danpillay87/puppet-base-cad/out/superseded/README.txt

DO NOT PRINT ANYTHING IN THIS FOLDER.

These are the old two-piece base plate halves (base_plate_left, base_plate_right) and
their assembly copies. On 23 Oct 2026 they were replaced by the one-piece
out/base_plate.stl, which is the one to print. They are kept here for reference only.
