danpillay87/puppet-base-cad/out/preview_rest.png

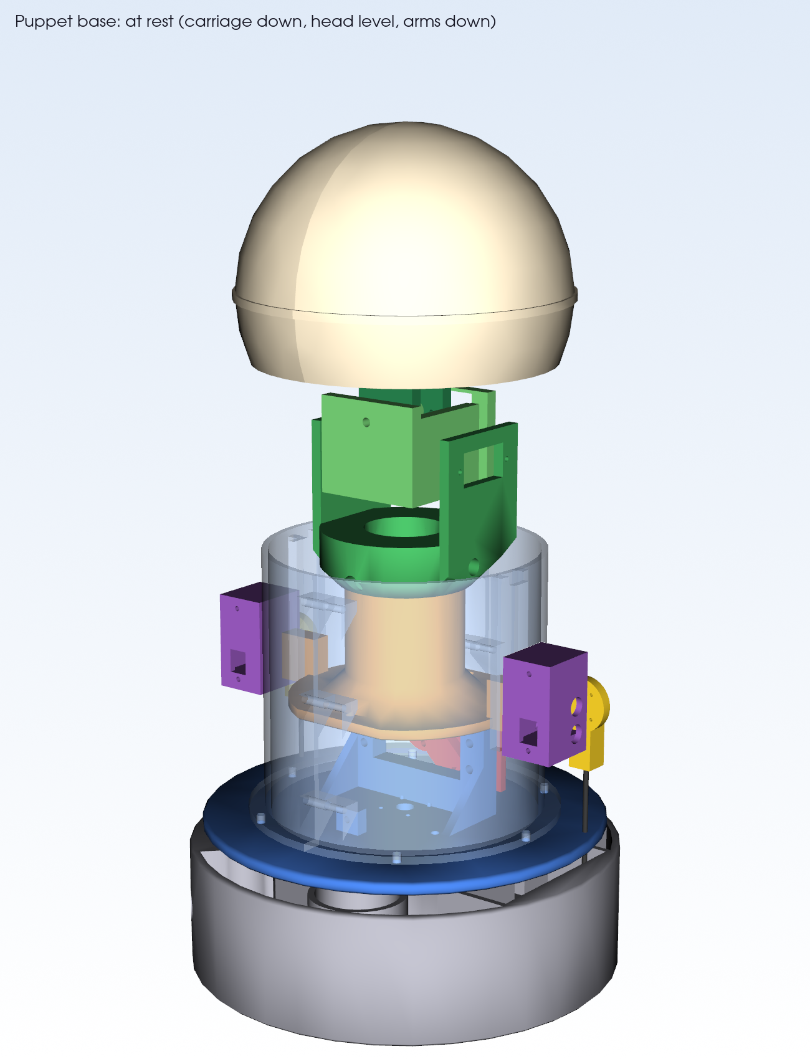
out/preview_rest.png
