danpillay87/puppet-base-cad/sim/assets/cad/cad-check.png

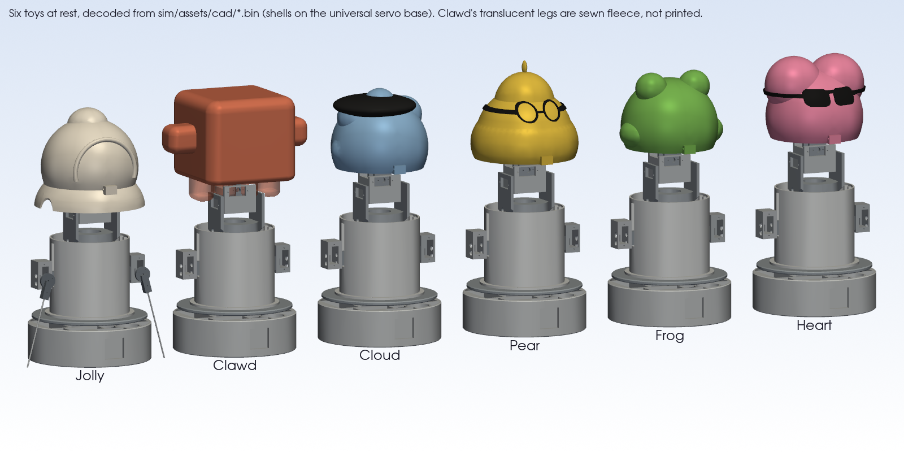
sim/assets/cad/cad-check.png
