danpillay87/puppet-base-cad/out/_assembly/_pose/bobbed/base.stl

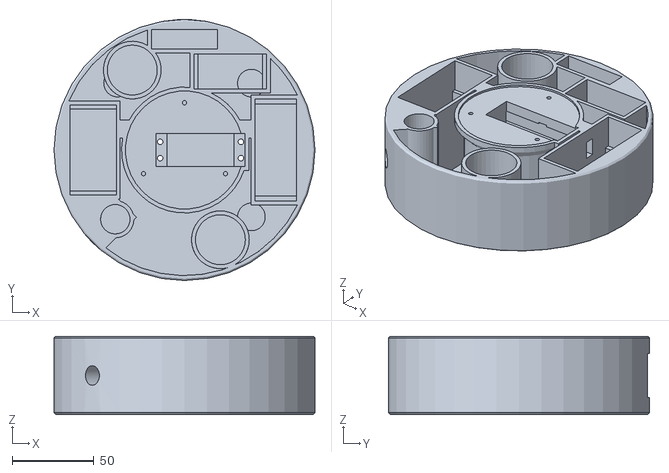
[picture p10: CAD file, 2026-10-24]
out/_assembly/_pose/bobbed/base.stl
160.0 x 160.0 x 48.0
