danpillay87/puppet-base-cad/out/_assembly/_pose/claude_bobbed/neck_B.stl

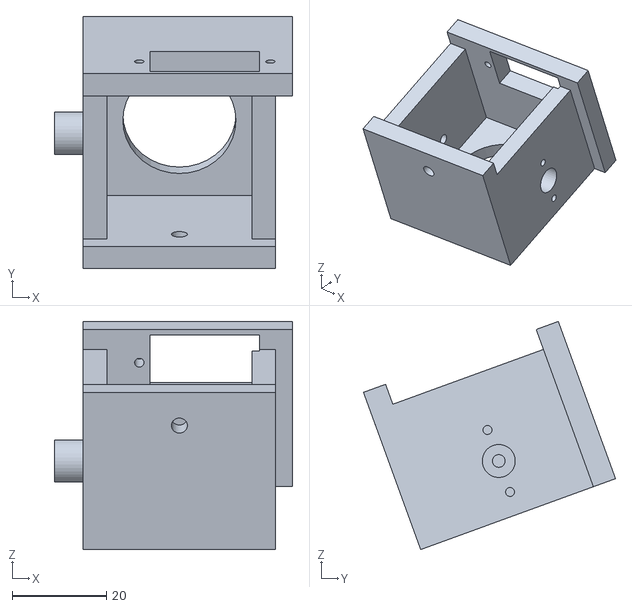
[picture p11: CAD file, 2026-10-23]
out/_assembly/_pose/claude_bobbed/neck_B.stl
50.5 x 53.5 x 48.4
