danpillay87/puppet-base-cad/out/_assembly/_pose/claude_rest/neck_A.stl

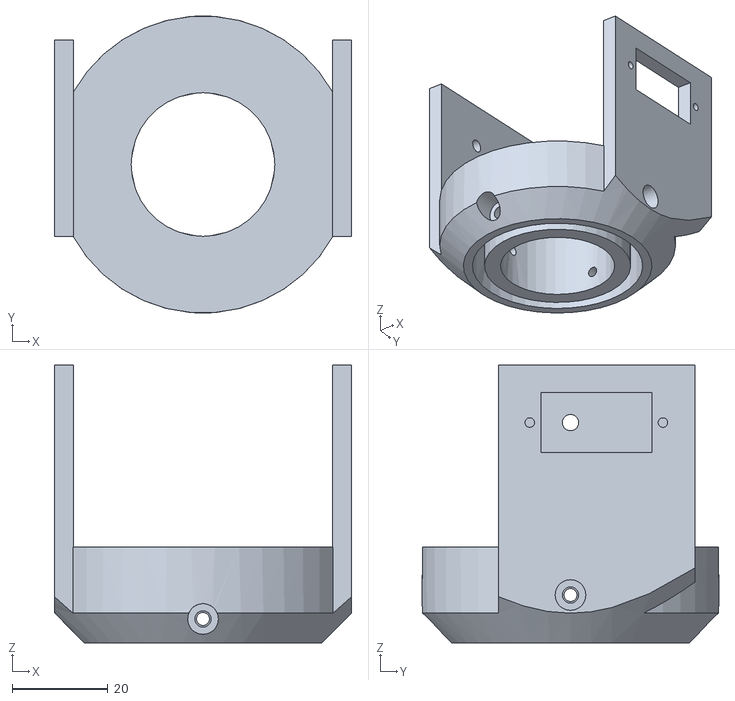
[picture p12: CAD file, 2026-10-23]
out/_assembly/_pose/claude_rest/neck_A.stl
62.0 x 62.0 x 58.0
