danpillay87/puppet-base-cad/out/_assembly/_shells/_pose/wearer_glasses.stl

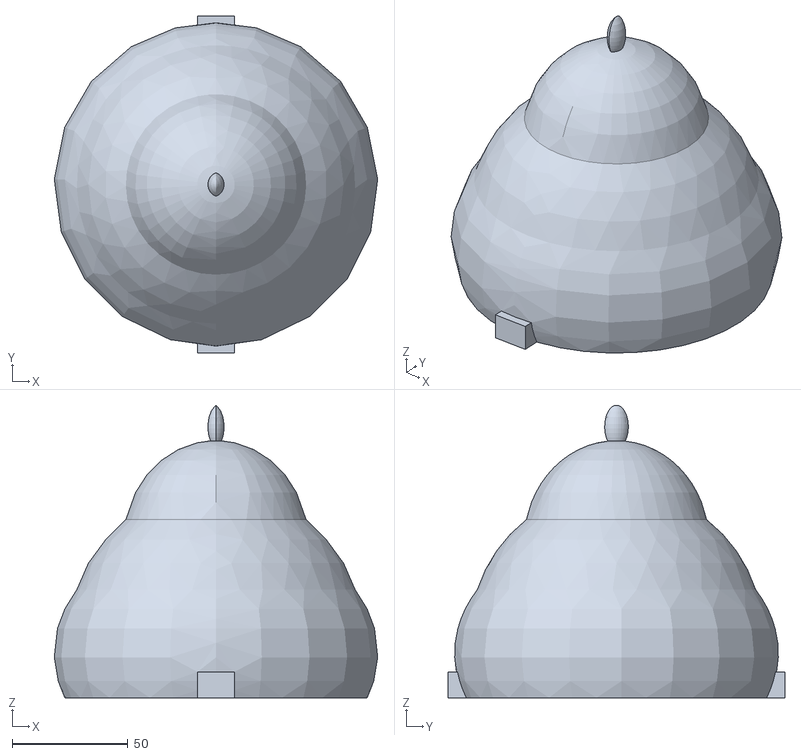
[picture p13: CAD file, 2026-10-23]
out/_assembly/_shells/_pose/wearer_glasses.stl
139.9 x 145.7 x 126.5
