danpillay87/puppet-base-cad/out/_assembly/_shells/glasses.stl

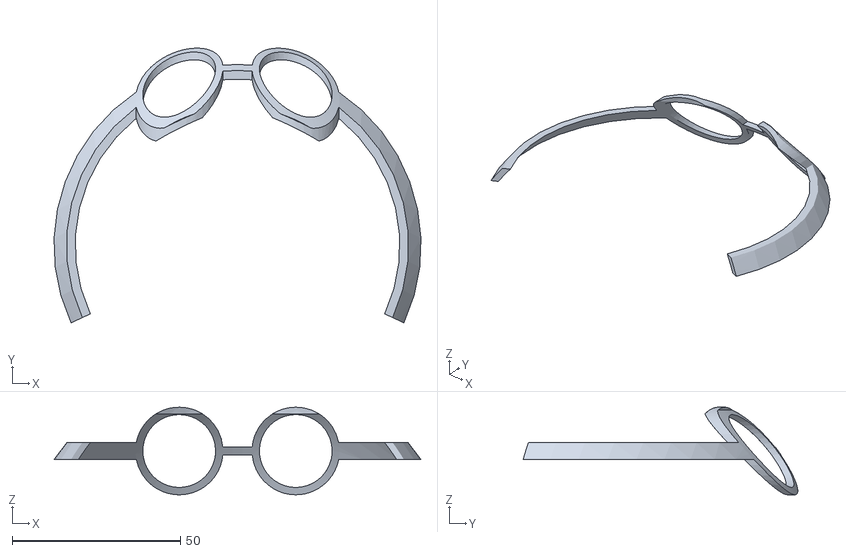
[picture p14: CAD file, 2026-10-23]
out/_assembly/_shells/glasses.stl
108.9 x 81.5 x 26.0
