danpillay87/puppet-base-cad/out/_assembly/_pose/claude_bobbed/turntable_hub.stl

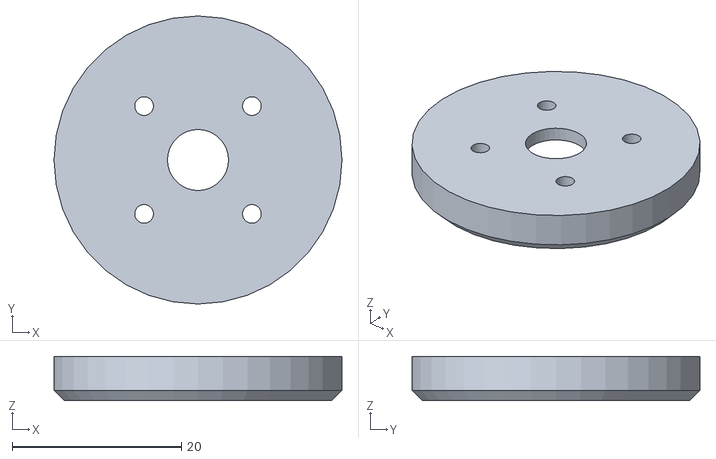
[picture p15: CAD file, 2026-10-23]
out/_assembly/_pose/claude_bobbed/turntable_hub.stl
34.0 x 34.0 x 5.20
