danpillay87/puppet-base-cad/out/_assembly/_pose/claude_rest/base.stl

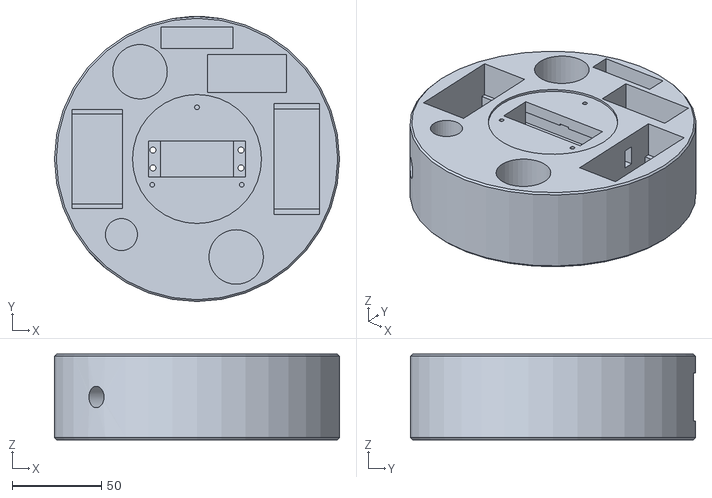
[picture p16: CAD file, 2026-10-23]
out/_assembly/_pose/claude_rest/base.stl
160.0 x 160.0 x 48.0
