danpillay87/puppet-base-cad/out/_assembly/_pose/cloud/turntable.stl

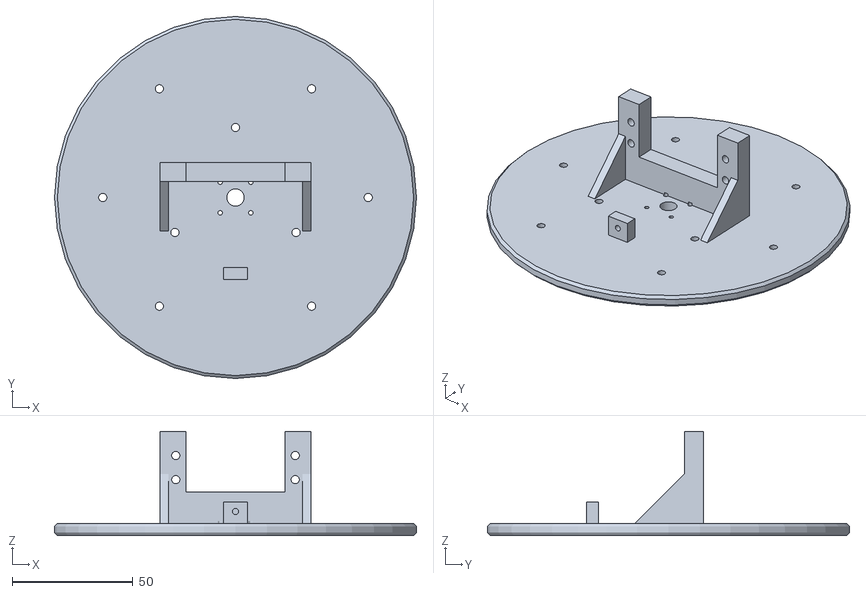
[picture p17: CAD file, 2026-10-23]
out/_assembly/_pose/cloud/turntable.stl
150.0 x 150.0 x 43.2
