danpillay87/puppet-base-cad/out/_assembly/_pose/rest/socket_L.stl

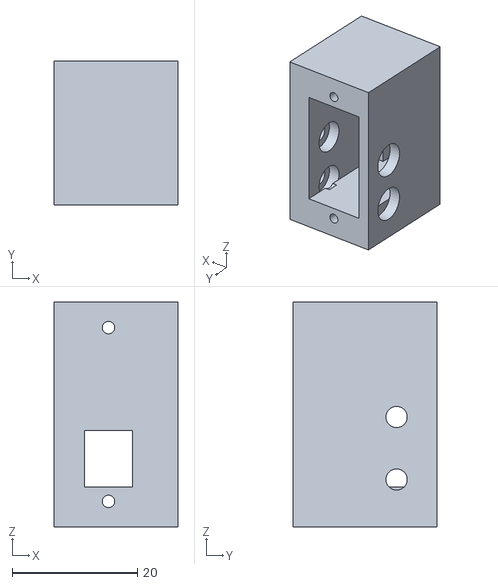
[picture p18: CAD file, 2026-10-23]
out/_assembly/_pose/rest/socket_L.stl
19.8 x 23.1 x 36.0
