danpillay87/puppet-base-cad/out/_assembly/_shells/sunglasses.stl

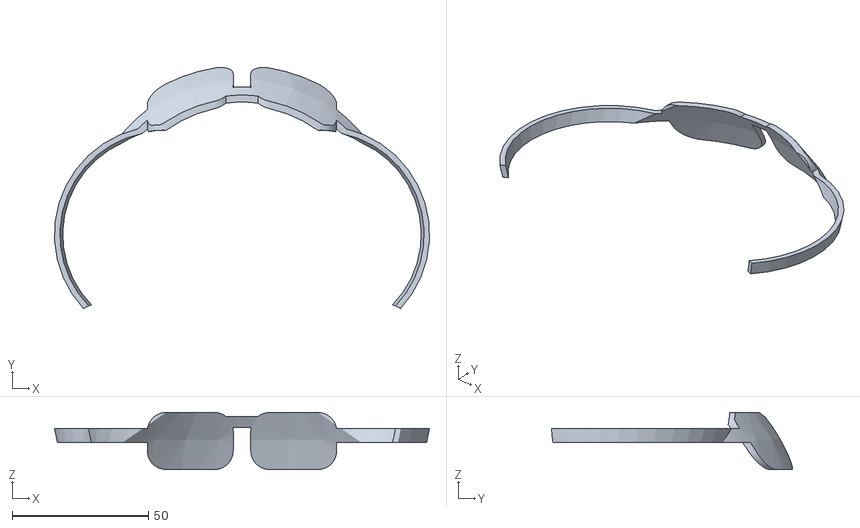
[picture p19: CAD file, 2026-10-23]
out/_assembly/_shells/sunglasses.stl
137.7 x 88.5 x 21.0
