danpillay87/puppet-base-cad/out/neck_rocker_B.stl

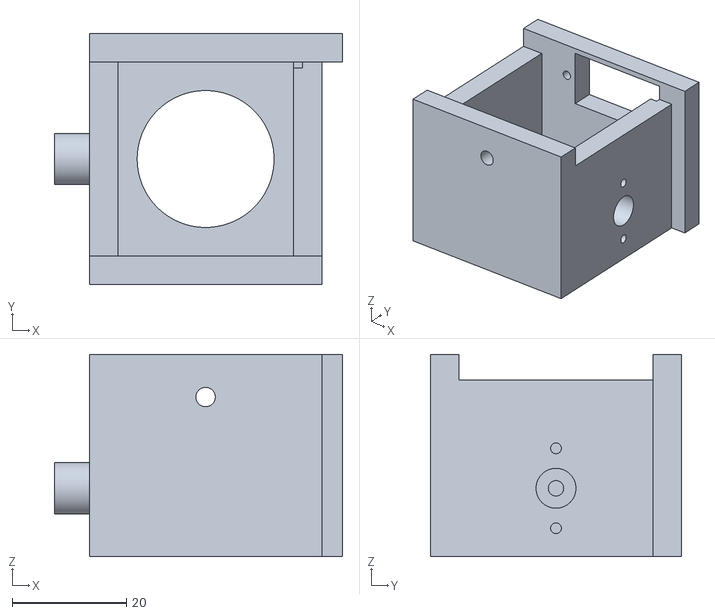
[picture p20: CAD file, 2026-10-23]
out/neck_rocker_B.stl
50.5 x 44.0 x 35.5
