danpillay87/puppet-base-cad/out/_assembly/_shells/claude_legs.stl

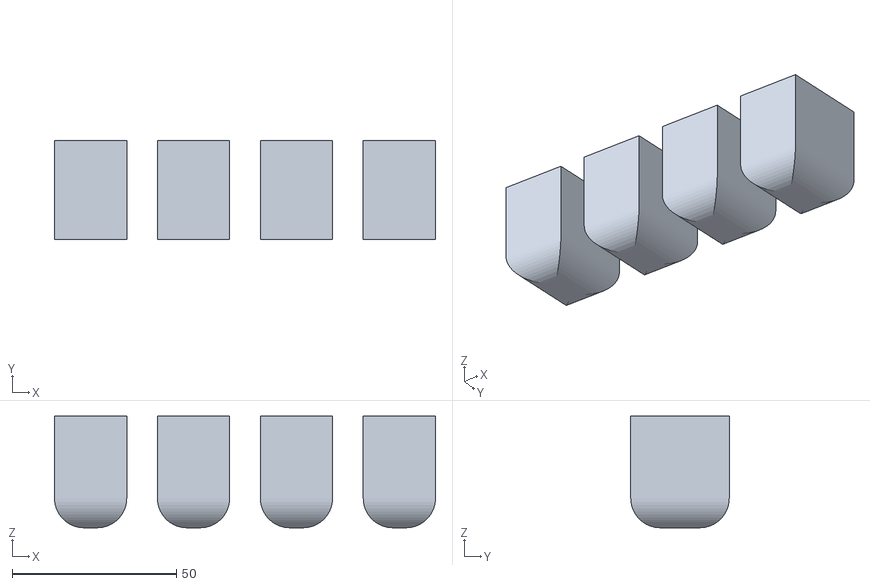
[picture p21: CAD file, 2026-10-20]
out/_assembly/_shells/claude_legs.stl
116.0 x 30.0 x 34.0
