danpillay87/puppet-base-cad/out/_assembly/_shells/_pose/wearer_sunglasses.stl

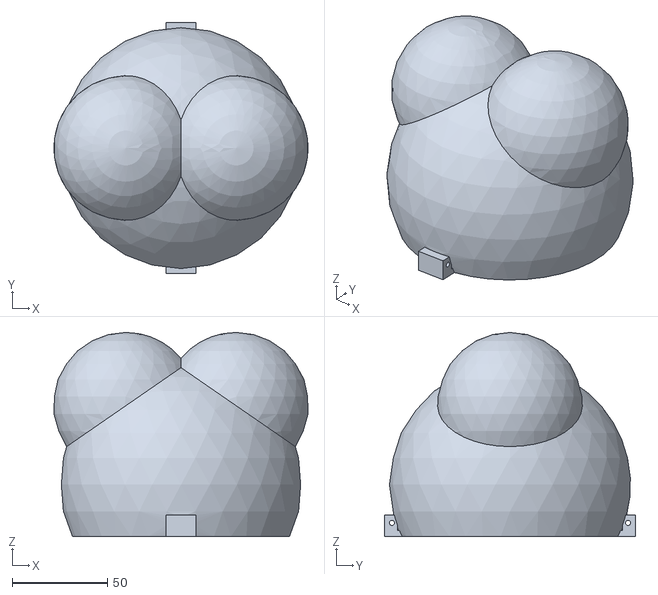
[picture p22: CAD file, 2026-10-23]
out/_assembly/_shells/_pose/wearer_sunglasses.stl
133.4 x 132.0 x 107.2
