danpillay87/puppet-base-cad/out/_assembly/_shells/claude.stl

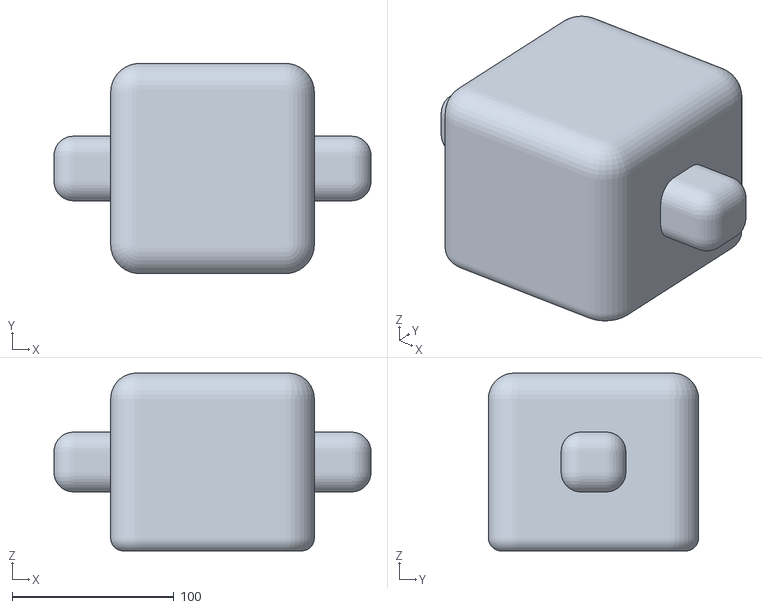
[picture p23: CAD file, 2026-10-20]
out/_assembly/_shells/claude.stl
196.0 x 130.0 x 110.0
