danpillay87/puppet-base-cad/out/_assembly/_shells/_pose/frog.stl

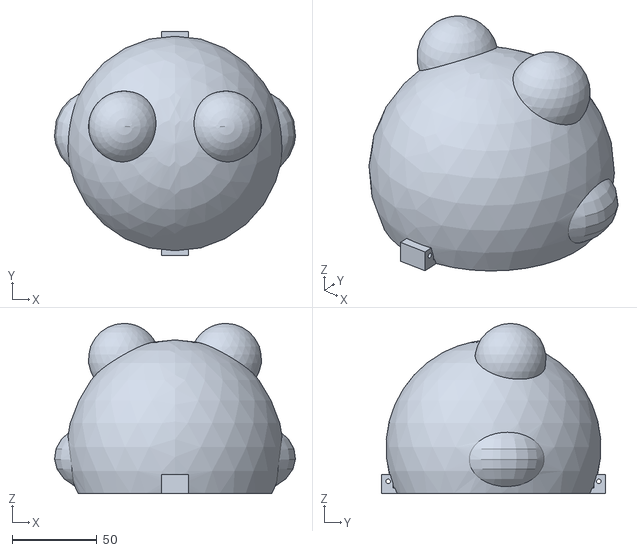
[picture p24: CAD file, 2026-10-20]
out/_assembly/_shells/_pose/frog.stl
141.8 x 132.0 x 100.2
