danpillay87/puppet-base-cad/out/_assembly/_shells/_pose/cloud.stl

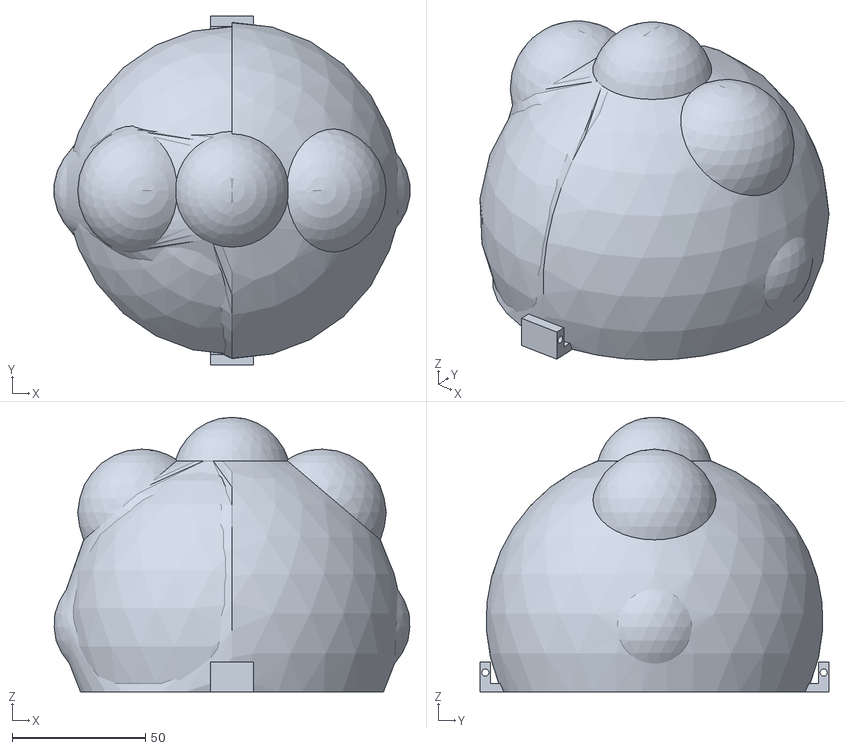
[picture p25: CAD file, 2026-10-20]
out/_assembly/_shells/_pose/cloud.stl
133.7 x 131.2 x 103.2
