danpillay87/puppet-base-cad/out/_assembly/_shells/beret.stl

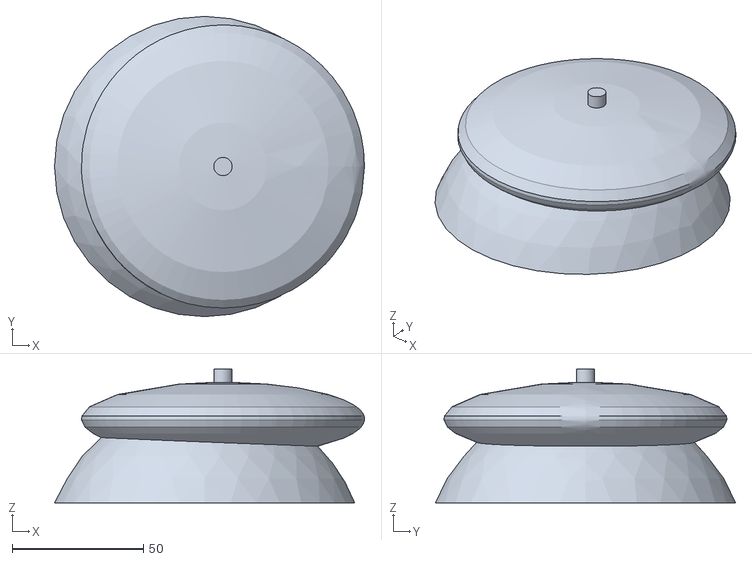
[picture p26: CAD file, 2026-10-18]
out/_assembly/_shells/beret.stl
118.3 x 114.5 x 51.0
