danpillay87/puppet-base-cad/out/_assembly/_shells/_pose/jolly.stl

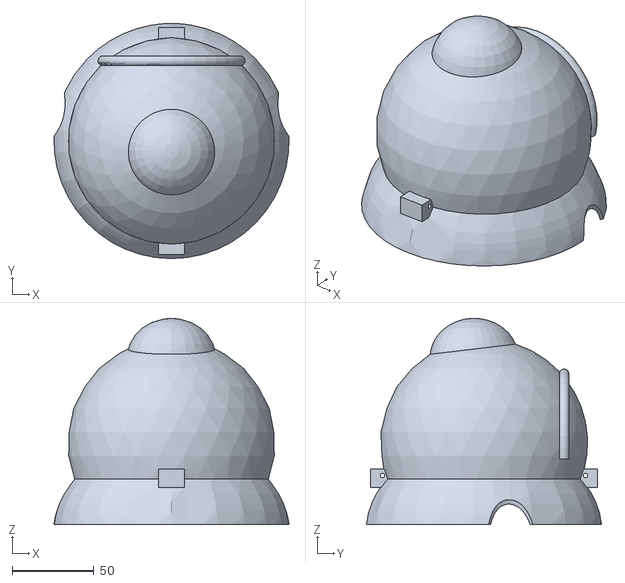
[picture p27: CAD file, 2026-10-20]
out/_assembly/_shells/_pose/jolly.stl
143.5 x 143.6 x 126.0
