danpillay87/puppet-base-cad/out/_assembly/_pose/bobbed/base_L.stl

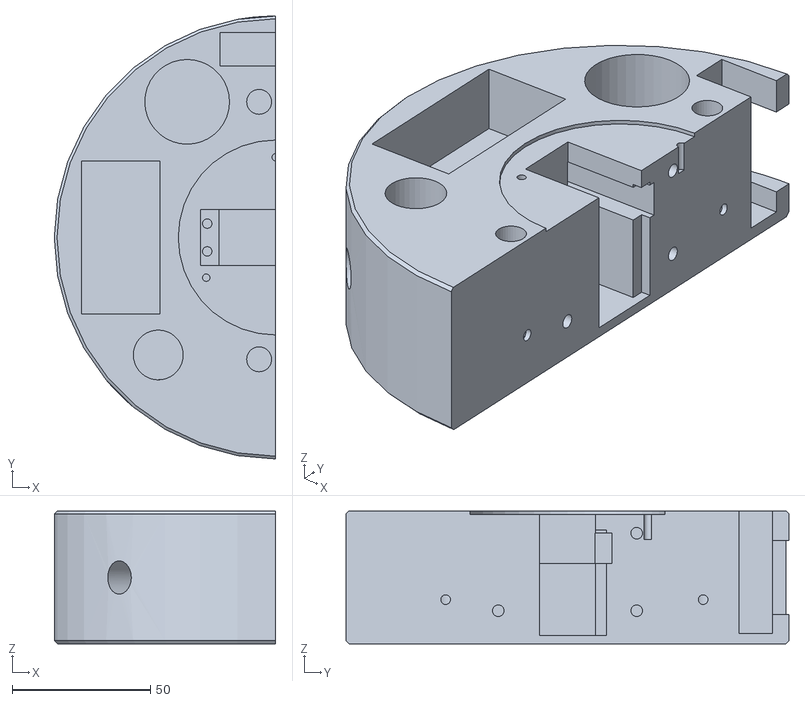
[picture p28: CAD file, 2026-10-18]
out/_assembly/_pose/bobbed/base_L.stl
80.0 x 160.0 x 48.0
