danpillay87/puppet-base-cad/out/_assembly/_pose/claude_bobbed/claude_legs.stl

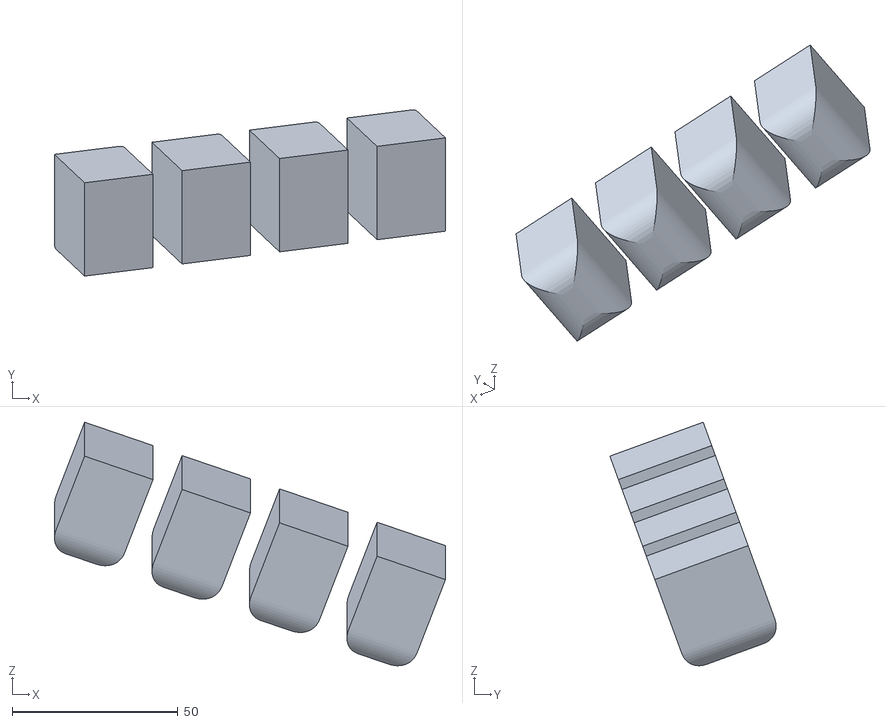
[picture p29: CAD file, 2026-10-20]
out/_assembly/_pose/claude_bobbed/claude_legs.stl
118.1 x 50.2 x 73.6
