danpillay87/puppet-base-cad/out/_assembly/_pose/claude_rest/lever.stl

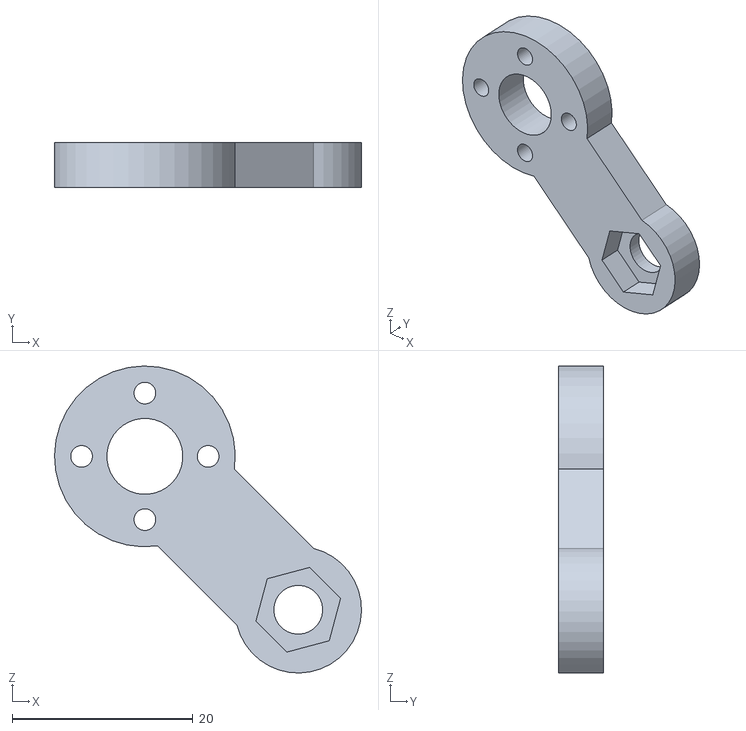
[picture p30: CAD file, 2026-10-20]
out/_assembly/_pose/claude_rest/lever.stl
34.0 x 5.00 x 34.0
