danpillay87/puppet-base-cad/out/_assembly/_pose/bobbed/base_R.stl

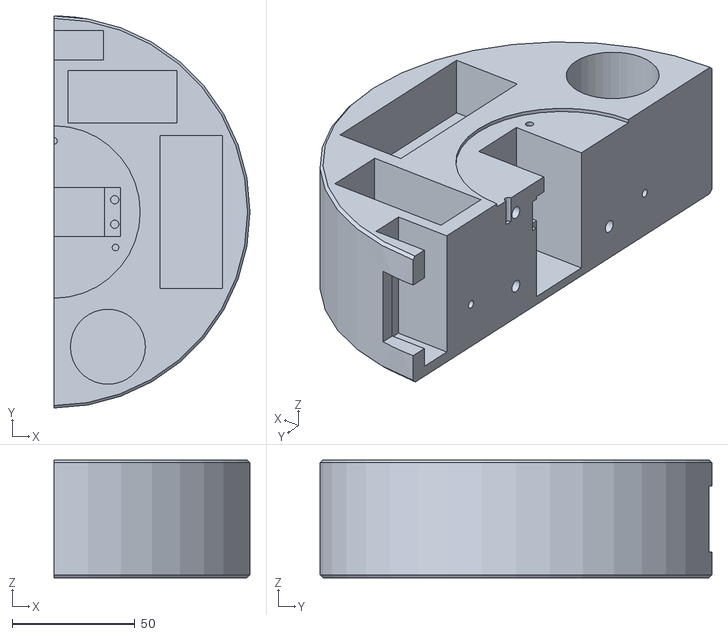
[picture p32: CAD file, 2026-10-18]
out/_assembly/_pose/bobbed/base_R.stl
80.0 x 160.0 x 48.0
