danpillay87/puppet-base-cad/out/_assembly/_pose/cloud/carriage.stl

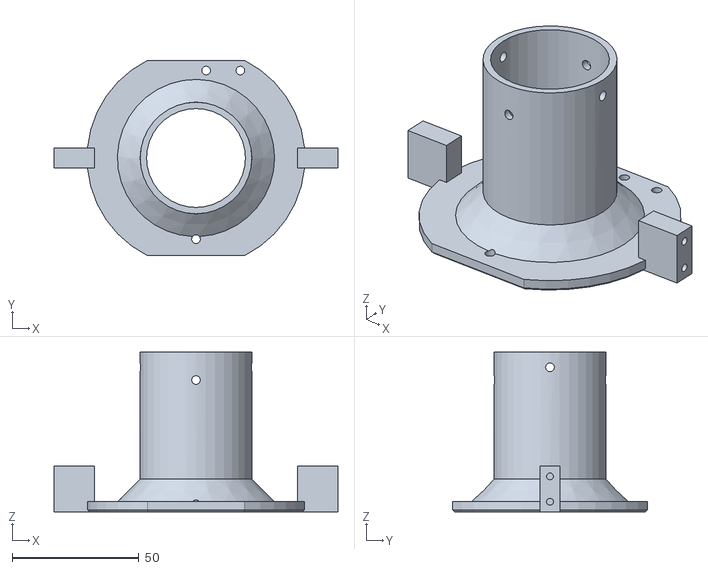
[picture p33: CAD file, 2026-10-18]
out/_assembly/_pose/cloud/carriage.stl
112.0 x 77.0 x 63.0
