danpillay87/puppet-base-cad/out/_assembly/_pose/rest/head_R.stl

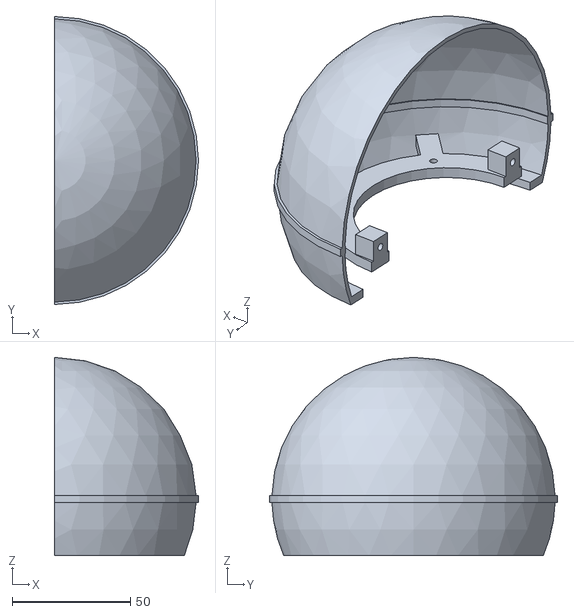
[picture p34: CAD file, 2026-10-18]
out/_assembly/_pose/rest/head_R.stl
61.0 x 122.0 x 84.0
