danpillay87/puppet-base-cad/out/_assembly/horn_L.stl

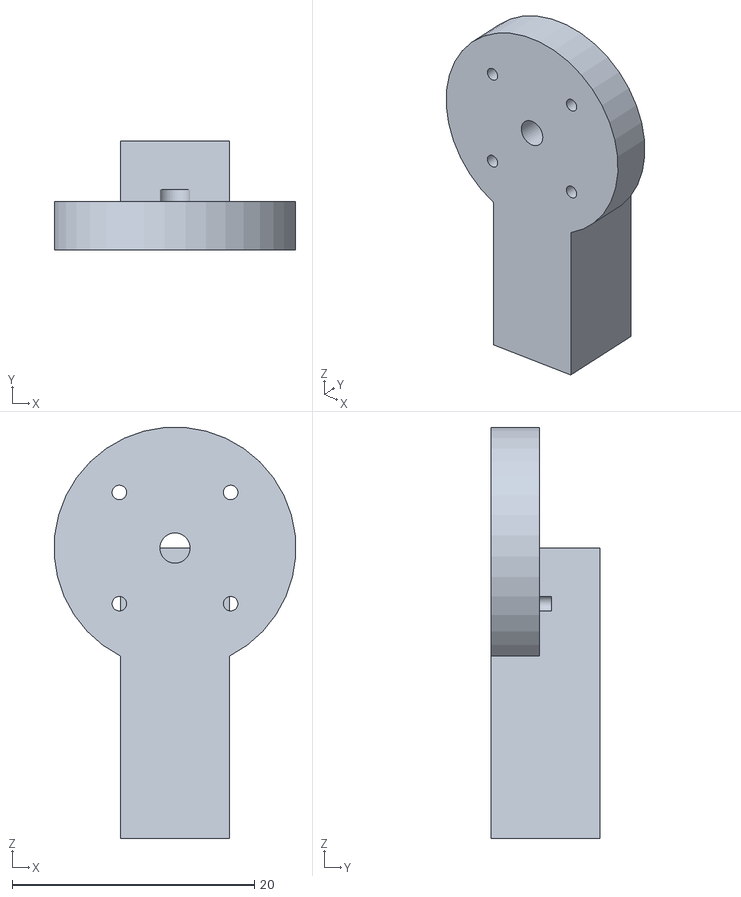
[picture p35: CAD file, 2026-10-18]
out/_assembly/horn_L.stl
20.0 x 9.00 x 34.0
