danpillay87/puppet-base-cad/out/_assembly/_pose/claude_bobbed/claude_R.stl

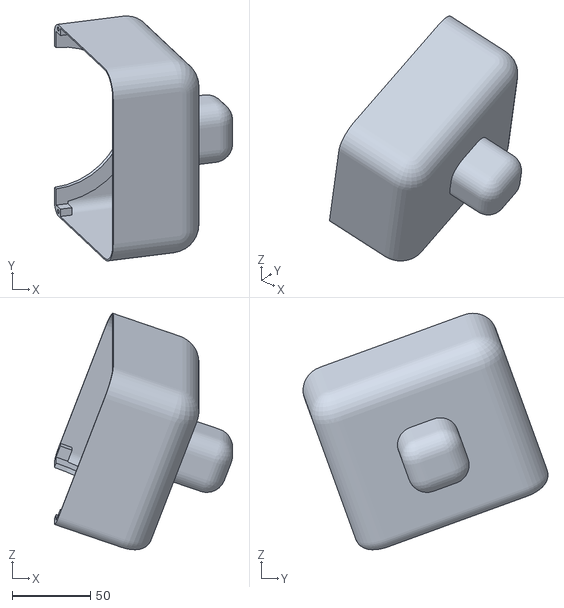
[picture p36: CAD file, 2026-10-20]
out/_assembly/_pose/claude_bobbed/claude_R.stl
113.8 x 156.4 x 151.1
