danpillay87/puppet-base-cad/out/_assembly/_pose/claude_rest/column_R.stl

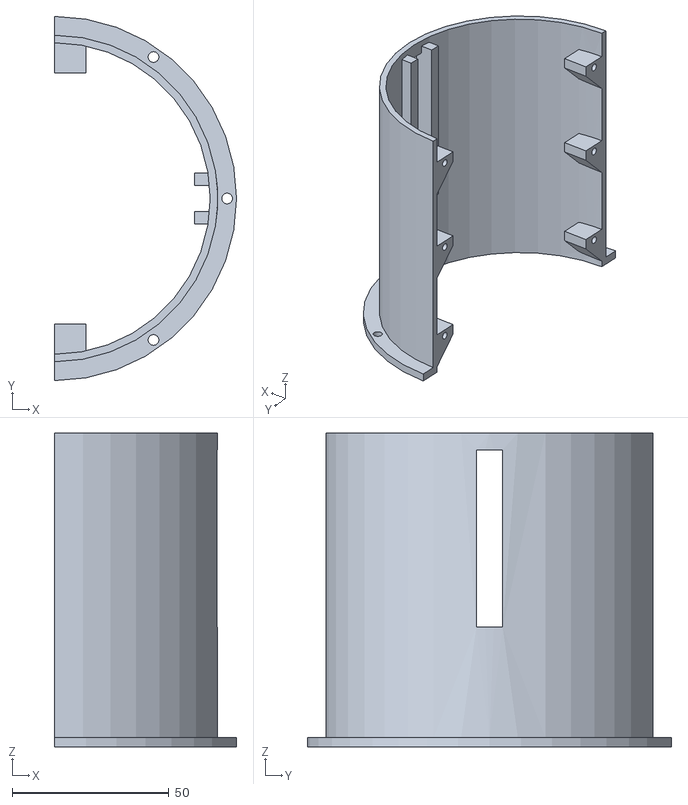
[picture p37: CAD file, 2026-10-20]
out/_assembly/_pose/claude_rest/column_R.stl
58.0 x 116.0 x 100.0
