danpillay87/puppet-base-cad/out/_assembly/_pose/cloud/wire_L.stl

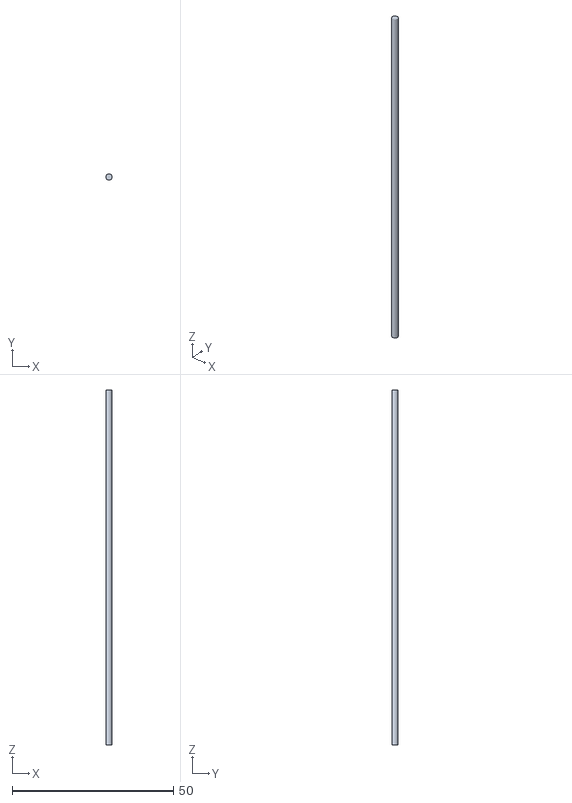
[picture p38: CAD file, 2026-10-18]
out/_assembly/_pose/cloud/wire_L.stl
2.00 x 2.00 x 110.0
