danpillay87/puppet-base-cad/out/dummy_core.stl

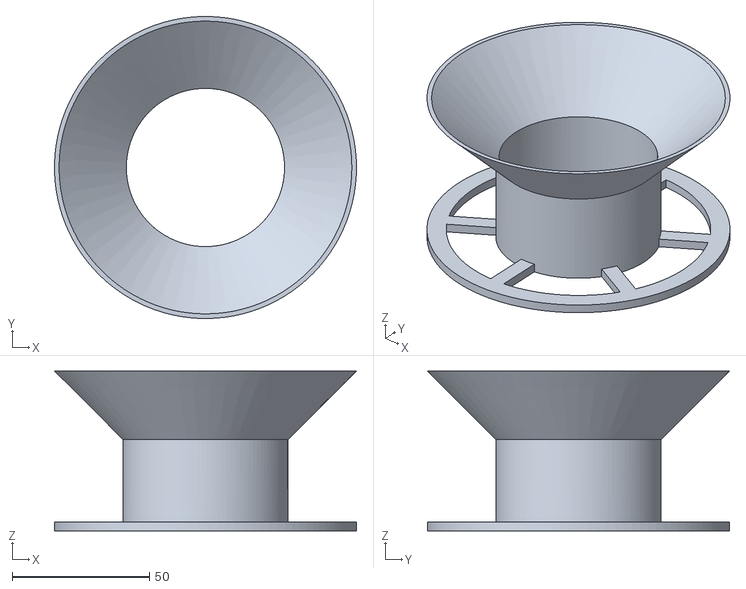
[picture p39: CAD file, 2026-10-23]
out/dummy_core.stl
110.0 x 110.0 x 58.2
