danpillay87/puppet-base-cad/out/_assembly/_pose/bobbed/horn_R.stl

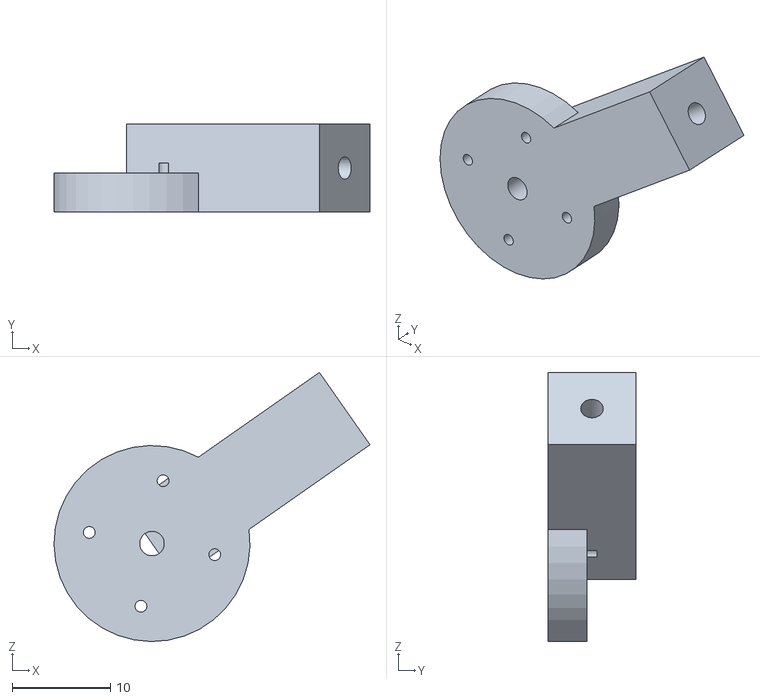
[picture p40: CAD file, 2026-10-18]
out/_assembly/_pose/bobbed/horn_R.stl
32.2 x 9.00 x 27.5
