danpillay87/puppet-base-cad/out/_assembly/cloud_R.stl

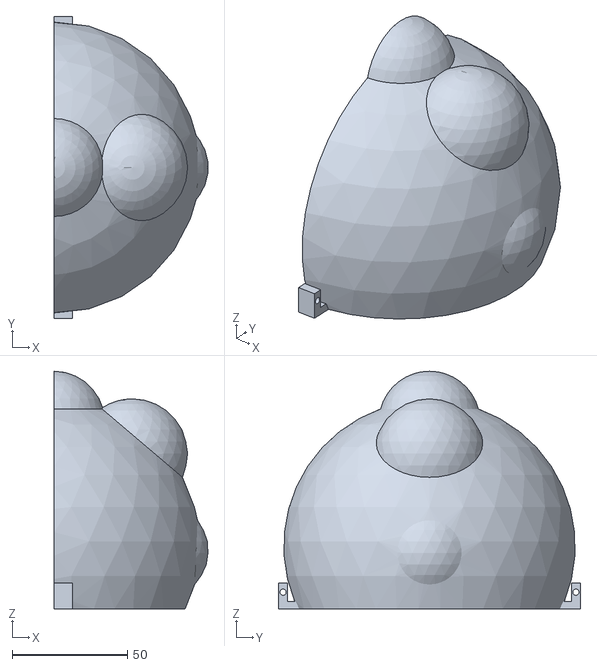
[picture p41: CAD file, 2026-10-18]
out/_assembly/cloud_R.stl
66.8 x 131.2 x 103.2
