danpillay87/puppet-base-cad/out/shell_claude_left.stl

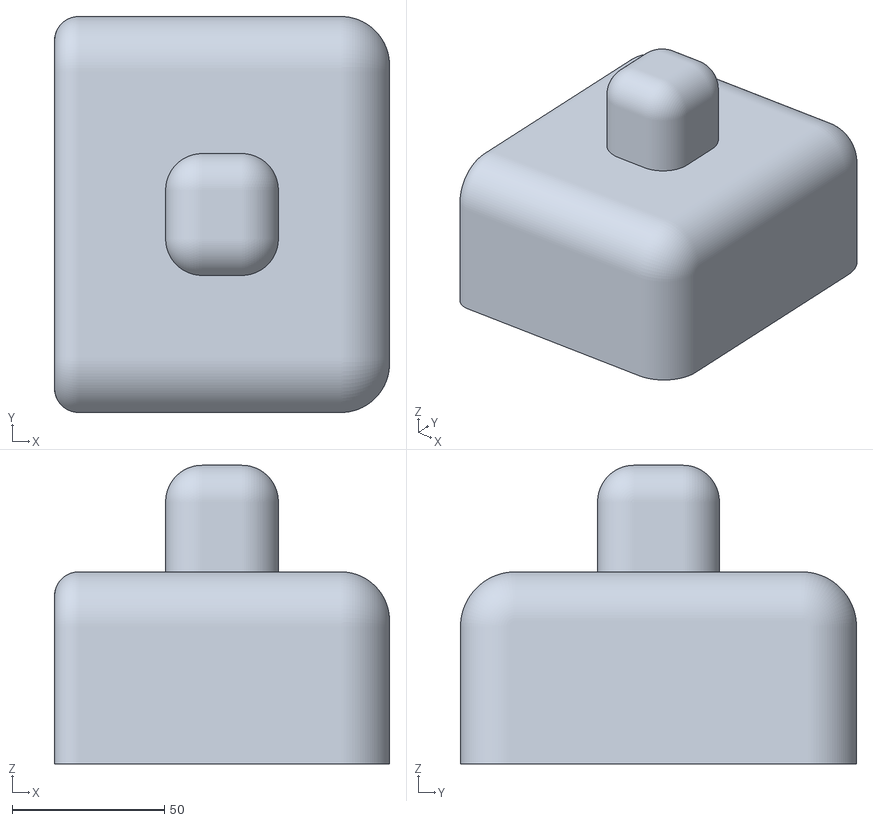
[picture p42: CAD file, 2026-10-20]
out/shell_claude_left.stl
110.0 x 130.0 x 98.0
