danpillay87/puppet-base-cad/out/_assembly/_pose/bobbed/wire_L.stl

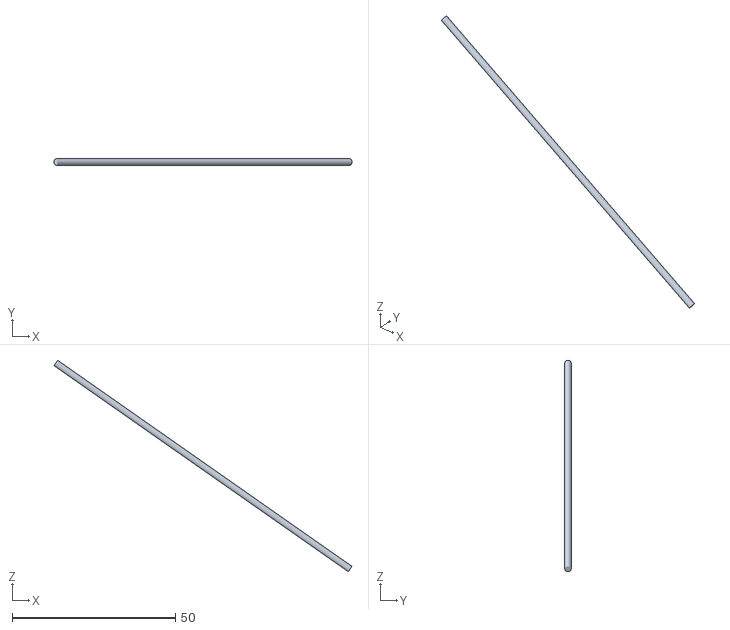
[picture p43: CAD file, 2026-10-18]
out/_assembly/_pose/bobbed/wire_L.stl
91.3 x 2.00 x 64.7
