danpillay87/puppet-base-cad/out/_assembly/_pose/claude_bobbed/neck_C.stl

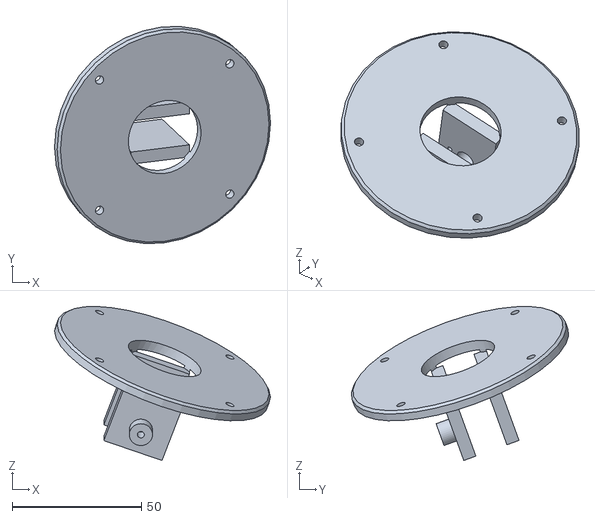
[picture p44: CAD file, 2026-10-20]
out/_assembly/_pose/claude_bobbed/neck_C.stl
83.7 x 84.2 x 59.7
