danpillay87/puppet-base-cad/out/_assembly/_shells/_pose/head_glasses.stl

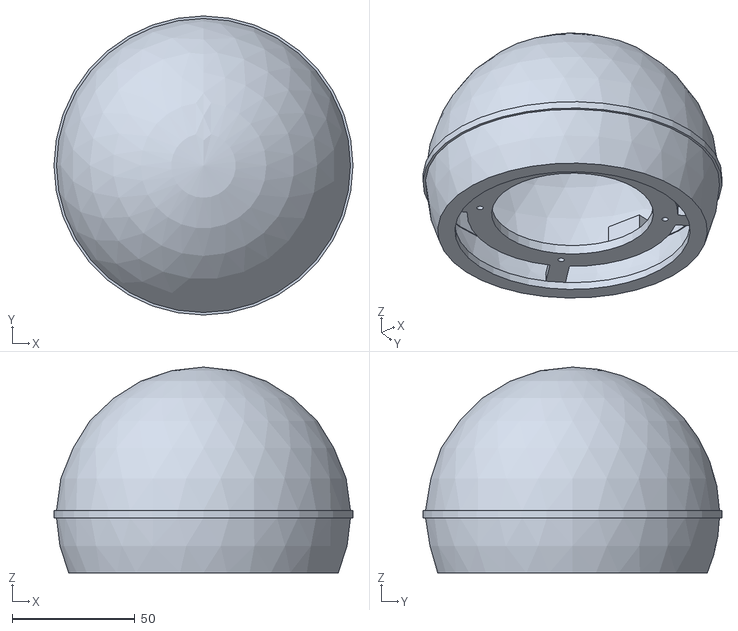
[picture p45: CAD file, 2026-10-18]
out/_assembly/_shells/_pose/head_glasses.stl
122.0 x 122.0 x 84.0
