danpillay87/puppet-base-cad/out/neck_head_plate_C.stl

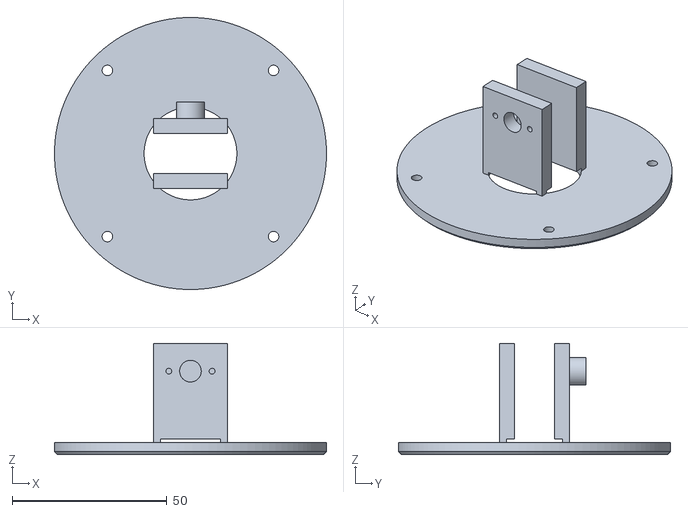
[picture p46: CAD file, 2026-10-18]
out/neck_head_plate_C.stl
88.0 x 88.0 x 36.0
