danpillay87/puppet-base-cad/out/_assembly/_pose/bobbed/head_L.stl

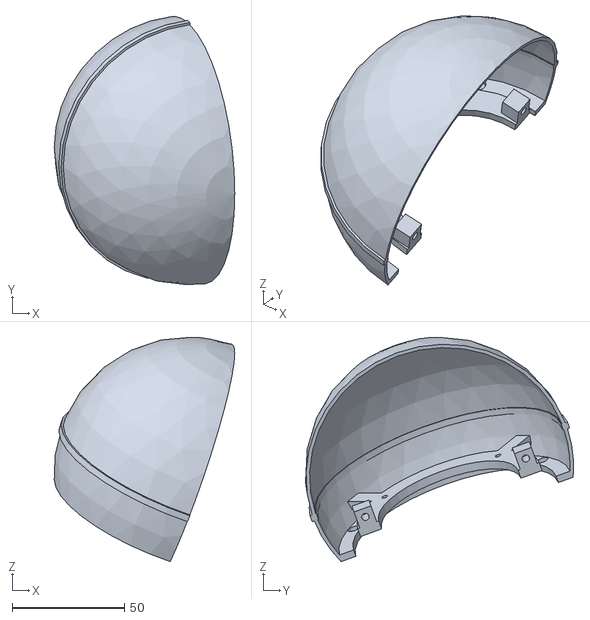
[picture p47: CAD file, 2026-10-18]
out/_assembly/_pose/bobbed/head_L.stl
80.4 x 119.3 x 99.9
