danpillay87/puppet-base-cad/out/shell_jolly_left.stl

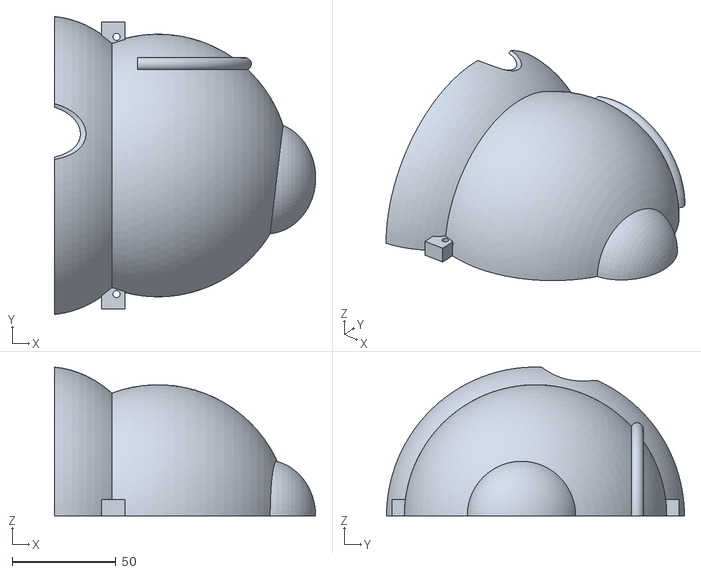
[picture p48: CAD file, 2026-10-18]
out/shell_jolly_left.stl
126.0 x 143.6 x 71.8
