danpillay87/puppet-base-cad/out/_assembly/_pose/claude_bobbed/head_R.stl

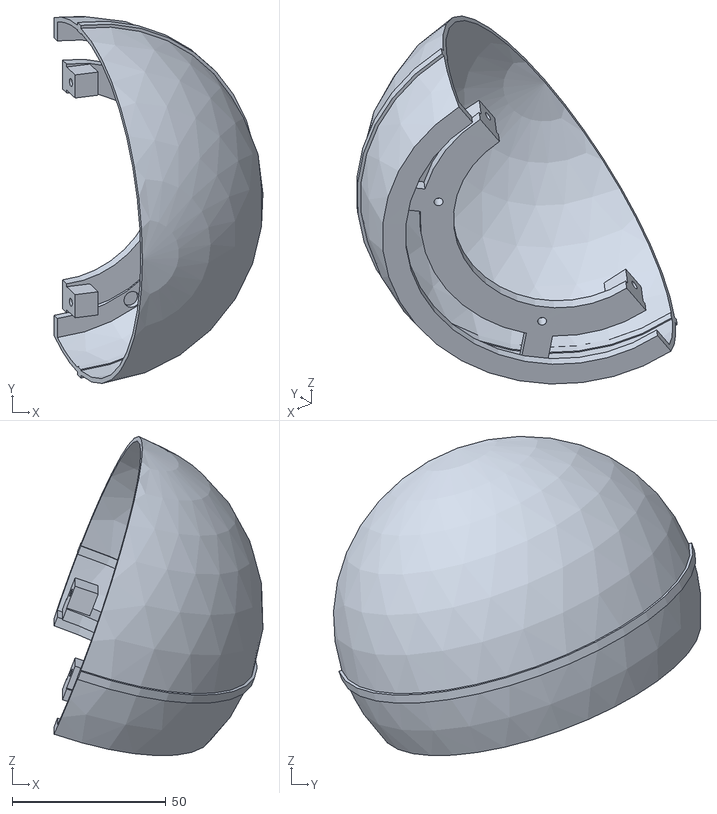
[picture p49: CAD file, 2026-10-20]
out/_assembly/_pose/claude_bobbed/head_R.stl
67.9 x 119.3 x 103.7
