danpillay87/puppet-base-cad/out/shoulder_cap.stl

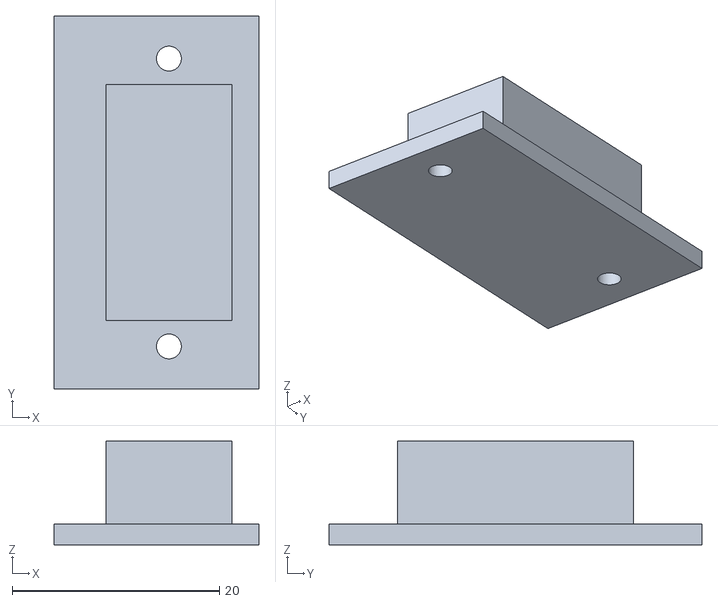
[picture p50: CAD file, 2026-10-18]
out/shoulder_cap.stl
19.8 x 36.0 x 10.0
