danpillay87/puppet-base-cad/out/_assembly/neck_C.stl

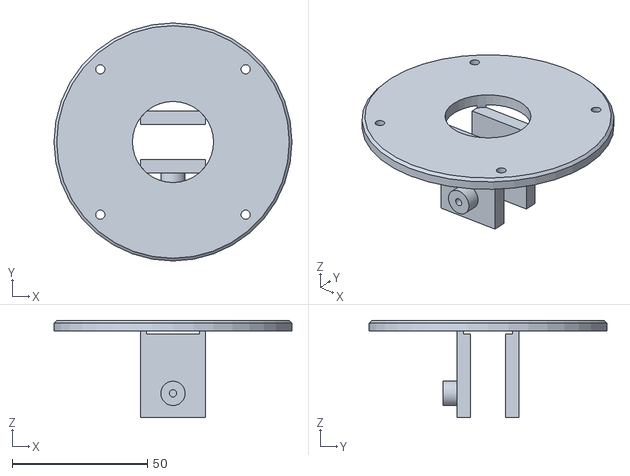
[picture p51: CAD file, 2026-10-18]
out/_assembly/neck_C.stl
88.0 x 88.0 x 36.0
