danpillay87/puppet-base-cad/out/shell_frog_right.stl

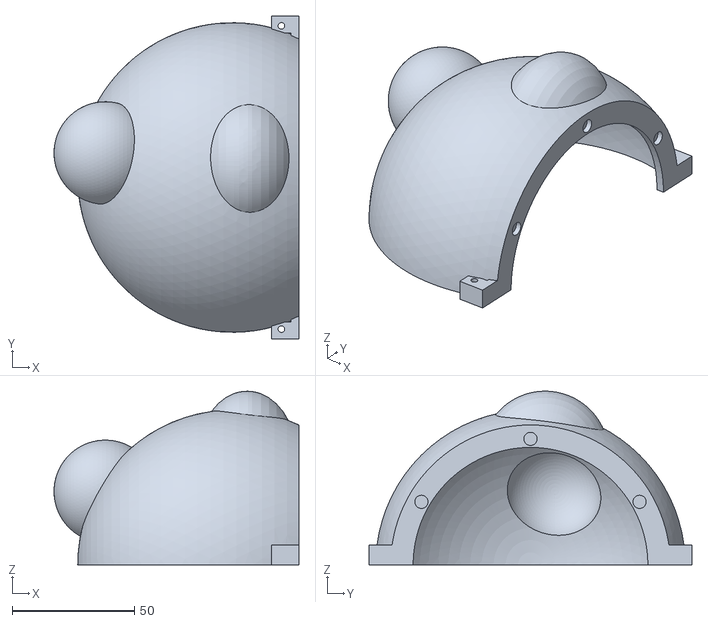
[picture p52: CAD file, 2026-10-18]
out/shell_frog_right.stl
100.2 x 132.0 x 71.0
