danpillay87/puppet-base-cad/out/_assembly/_pose/bobbed/yoke.stl

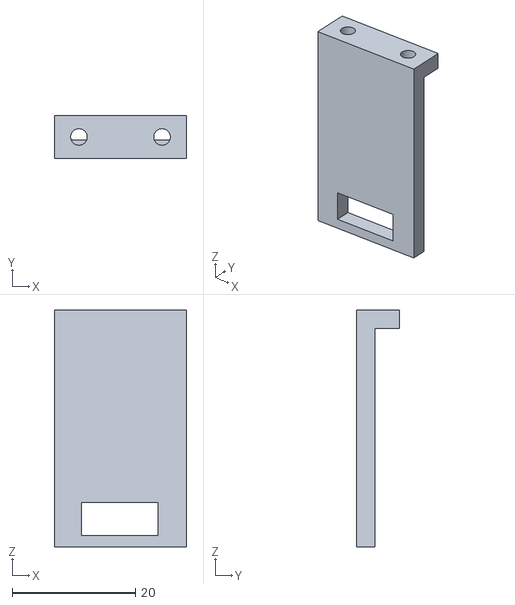
[picture p53: CAD file, 2026-10-18]
out/_assembly/_pose/bobbed/yoke.stl
21.5 x 7.00 x 38.5
