danpillay87/puppet-base-cad/out/shell_heart_left.stl

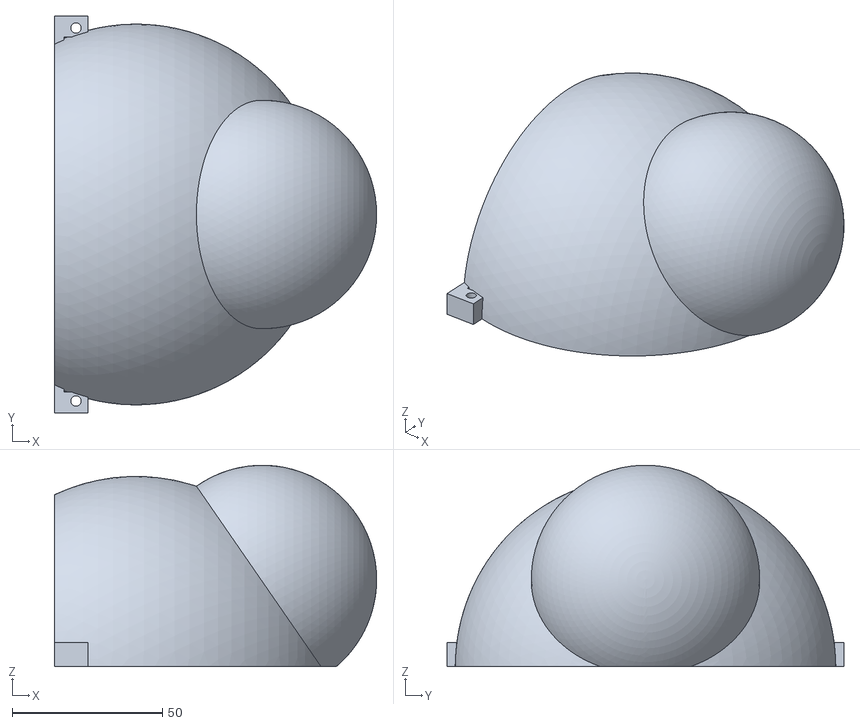
[picture p54: CAD file, 2026-10-18]
out/shell_heart_left.stl
107.2 x 132.0 x 67.0
