danpillay87/puppet-base-cad/(list of files, cad)

Other CAD files:
out/_assembly/base.stl
out/base_plate.stl
out/_assembly/_pose/bobbed/neck_B.stl
out/_assembly/_shells/_pose/glasses.stl
out/_assembly/_pose/bobbed/socket_L.stl
out/_assembly/_pose/claude_bobbed/socket_R.stl
out/_assembly/_pose/claude_rest/neck_B.stl
out/_assembly/_pose/rest/neck_A.stl
out/_assembly/_shells/_pose/sunglasses.stl
out/_assembly/neck_A.stl
out/turntable_hub.stl
out/_assembly/_pose/bobbed/socket_R.stl
out/_assembly/_pose/claude_bobbed/neck_A.stl
out/_assembly/_pose/claude_rest/socket_R.stl
out/_assembly/_pose/cloud/turntable_hub.stl
out/_assembly/_pose/rest/neck_B.stl
out/_assembly/socket_R.stl
out/clip_glasses_round.stl
out/_assembly/_pose/claude_bobbed/base.stl
out/_assembly/_pose/claude_rest/turntable.stl
out/_assembly/_pose/cloud/neck_A.stl
out/_assembly/_shells/frog.stl
out/turntable.stl
out/_assembly/_pose/bobbed/turntable_hub.stl
out/_assembly/_pose/claude_bobbed/socket_L.stl
out/_assembly/_pose/claude_rest/socket_L.stl
out/_assembly/_pose/cloud/socket_R.stl
out/_assembly/_pose/rest/socket_R.stl
out/_assembly/neck_B.stl
out/clip_sunglasses.stl
out/_assembly/_pose/bobbed/neck_A.stl
out/_assembly/_pose/claude_bobbed/turntable.stl
out/_assembly/_pose/claude_rest/turntable_hub.stl
out/_assembly/_pose/cloud/neck_B.stl
out/_assembly/_pose/rest/turntable_hub.stl
out/_assembly/_shells/jolly.stl
out/_assembly/turntable_hub.stl
out/neck_base_A.stl
out/_assembly/_shells/_pose/pear.stl
out/_assembly/_shells/heart.stl
out/_assembly/lever.stl
out/shoulder_socket_right.stl
out/_assembly/_pose/claude_bobbed/base_R.stl
out/_assembly/_pose/claude_rest/base_L.stl
out/_assembly/_shells/_pose/claude_legs.stl
out/_assembly/_shells/pear.stl
out/shoulder_socket_left.stl
out/_assembly/_pose/bobbed/lever.stl
out/_assembly/_shells/_pose/heart.stl
out/_assembly/_pose/claude_bobbed/carriage.stl
out/_assembly/_pose/claude_rest/yoke.stl
out/_assembly/_pose/cloud/column_R.stl
out/_assembly/_pose/rest/column_L.stl
out/_assembly/_shells/_pose/claude.stl
out/_assembly/_pose/claude_rest/carriage.stl
out/_assembly/_pose/rest/horn_R.stl
out/shell_claude_right.stl
out/_assembly/_pose/bobbed/wire_R.stl
out/_assembly/_pose/claude_bobbed/column_R.stl
out/_assembly/_pose/claude_rest/head_R.stl
out/_assembly/_pose/cloud/column_L.stl
out/_assembly/_shells/_pose/head_beret.stl
out/_assembly/column_R.stl
out/_assembly/_pose/claude_bobbed/claude_L.stl
out/_assembly/_pose/claude_rest/column_L.stl
out/_assembly/_pose/cloud/lever.stl
out/_assembly/_pose/rest/lever.stl
out/_assembly/_shells/_pose/head_sunglasses.stl
out/_assembly/_pose/bobbed/column_R.stl
out/_assembly/_pose/claude_rest/claude_legs.stl
out/_assembly/_pose/rest/horn_L.stl
out/_assembly/_shells/_pose/beret.stl
out/_assembly/column_L.stl
out/_assembly/_pose/bobbed/head_R.stl
out/_assembly/_pose/claude_bobbed/base_L.stl
out/_assembly/_pose/claude_rest/claude_L.stl
out/_assembly/_pose/rest/column_R.stl
out/_assembly/_pose/claude_bobbed/head_L.stl
out/_assembly/_pose/claude_rest/neck_C.stl
out/_assembly/_pose/cloud/wire_R.stl
out/_assembly/_pose/rest/head_L.stl
out/column_right.stl
out/_assembly/_pose/bobbed/horn_L.stl
out/_assembly/_pose/claude_bobbed/yoke.stl
out/_assembly/_pose/claude_rest/base_R.stl
out/_assembly/_pose/cloud/head_L.stl
out/_assembly/carriage.stl
out/_assembly/_pose/bobbed/carriage.stl
out/_assembly/_pose/bobbed/column_L.stl
out/_assembly/_pose/bobbed/neck_C.stl
out/_assembly/_pose/claude_bobbed/column_L.stl
out/_assembly/_pose/claude_bobbed/lever.stl
out/_assembly/_pose/claude_rest/claude_R.stl
out/_assembly/_pose/claude_rest/head_L.stl
out/_assembly/_pose/cloud/cloud_L.stl
out/_assembly/_pose/cloud/horn_L.stl
out/_assembly/_pose/cloud/horn_R.stl
out/_assembly/_pose/rest/wire_R.stl
out/_assembly/cloud_L.stl
out/_assembly/head_L.stl
out/_assembly/horn_R.stl
out/_assembly/wire_R.stl
out/arm_horn.stl
out/bob_carriage.stl
out/clip_beret.stl
out/cloud_former_left.stl
out/cloud_former_right.stl
out/column_left.stl
out/head_half_left.stl
out/head_half_right.stl
out/lift_lever.stl
out/lift_yoke.stl
out/shell_frog_left.stl
out/shell_heart_right.stl
out/shell_jolly_right.stl
out/shell_pear_left.stl
out/shell_pear_right.stl
out/skin_ring_1.stl
out/skin_ring_2.stl
out/skin_ring_3.stl
out/skin_ring_4.stl
out/superseded/_assembly/_pose/claude_bobbed/base_L.stl
out/superseded/_assembly/_pose/claude_bobbed/base_R.stl
out/superseded/_assembly/_pose/claude_rest/base_L.stl
out/superseded/_assembly/_pose/claude_rest/base_R.stl
out/superseded/_assembly/base_L.stl
out/superseded/_assembly/base_R.stl
out/superseded/base_plate_left.stl
out/superseded/base_plate_right.stl
