danpillay87/puppet-base-cad/out/_build_log.txt

base_plate               x1   160.1 x  160.1 x   48.1 mm    396.2 cm3   122.8 g (25%)   491.3 g (solid)   0.54 MB  supports: none (one piece; pockets open on top; speaker/jack holes bridge by a few mm)
turntable                x1   150.0 x  150.1 x   43.2 mm     99.1 cm3    30.7 g (25%)   122.9 g (solid)   0.46 MB  supports: none (plate down, cradle up; servo slot open at the top)
turntable_hub            x1    34.0 x   34.0 x    5.2 mm      2.7 cm3     0.8 g (25%)     3.4 g (solid)   0.16 MB  supports: none (floor down)
column_left              x1    58.1 x  116.1 x  100.1 mm     46.8 cm3    14.5 g (25%)    58.0 g (solid)   0.24 MB  supports: none (stands on its foot ring, lugs have 45 deg undersides)
column_right             x1    58.1 x  116.1 x  100.1 mm     47.0 cm3    14.6 g (25%)    58.3 g (solid)   0.24 MB  supports: none (stands on its foot ring, lugs have 45 deg undersides)
bob_carriage             x1   112.0 x   77.0 x   63.0 mm     47.0 cm3    14.6 g (25%)    58.3 g (solid)   0.35 MB  supports: none (frame down, stem up, 45 deg fillet)
lift_yoke                x1    21.5 x    7.0 x   38.5 mm      2.5 cm3     0.8 g (25%)     3.1 g (solid)   0.05 MB  supports: none (flange down, blade up)
lift_lever               x1    41.0 x   20.0 x    5.0 mm      2.3 cm3     0.7 g (25%)     2.8 g (solid)   0.16 MB  supports: none (flat)
neck_base_A              x1    62.3 x   62.0 x   58.1 mm     48.2 cm3    14.9 g (25%)    59.7 g (solid)   0.46 MB  supports: none (plug down; 45 deg sleeve under the flange and uprights)
neck_rocker_B            x1    50.5 x   44.0 x   35.5 mm     26.6 cm3     8.2 g (25%)    33.0 g (solid)   0.19 MB  supports: none (pivot boss is a short 4.5 mm radius stub)
neck_head_plate_C        x1    88.0 x   88.0 x   36.0 mm     28.7 cm3     8.9 g (25%)    35.6 g (solid)   0.25 MB  supports: none (plate down, legs up)
head_half_left           x1    84.2 x  122.1 x   61.1 mm     34.9 cm3    10.8 g (25%)    43.3 g (solid)   0.42 MB  supports: YES: crown of the dome (top ~30%) and the collar flange
head_half_right          x1    84.2 x  122.1 x   61.1 mm     35.0 cm3    10.8 g (25%)    43.4 g (solid)   0.42 MB  supports: YES: crown of the dome (top ~30%) and the collar flange
shoulder_socket_right    x1    19.8 x   36.0 x   23.1 mm      9.7 cm3     3.0 g (25%)    12.1 g (solid)   0.18 MB  supports: none (pocket opens upward)
shoulder_socket_left     x1    19.8 x   36.0 x   23.1 mm      9.7 cm3     3.0 g (25%)    12.1 g (solid)   0.18 MB  supports: none (pocket opens upward)
shoulder_cap             x0    19.8 x   36.0 x   10.0 mm      3.6 cm3     1.1 g (25%)     4.5 g (solid)   0.04 MB  supports: none (flange down); not needed on the shared base: both shoulder servos stay fitted
arm_horn                 x2    34.0 x   20.0 x    9.0 mm      2.7 cm3     0.8 g (25%)     3.4 g (solid)   0.17 MB  supports: none (disc down)
cloud_former_left        x1   103.3 x  131.2 x   67.1 mm     33.4 cm3    10.4 g (25%)    41.5 g (solid)   0.71 MB  supports: YES: puffs and crown; tree supports
cloud_former_right       x1   103.3 x  131.2 x   67.1 mm     33.5 cm3    10.4 g (25%)    41.5 g (solid)   0.71 MB  supports: YES: puffs and crown; tree supports
dummy_core               x5   110.4 x  110.4 x   58.4 mm     27.5 cm3     8.5 g (25%)    34.1 g (solid)   0.27 MB  supports: none (collar down, 45 deg cone)
skin_ring_1              x1   110.0 x  110.0 x    3.2 mm      6.9 cm3     2.1 g (25%)     8.5 g (solid)   0.31 MB  supports: none (flat)
skin_ring_2              x1   110.0 x  110.0 x    3.2 mm      6.9 cm3     2.1 g (25%)     8.5 g (solid)   0.32 MB  supports: none (flat)
skin_ring_3              x1   110.0 x  110.0 x    3.2 mm      6.9 cm3     2.1 g (25%)     8.5 g (solid)   0.33 MB  supports: none (flat)
skin_ring_4              x1   110.0 x  110.0 x    3.2 mm      6.9 cm3     2.1 g (25%)     8.5 g (solid)   0.34 MB  supports: none (flat)
base hollowing: 5 of 10 pockets cut (break-even 3.6 mm), 337 cm3 removed, about 38 g saved at 25% infill
assembly pose STLs written: 21
overall height, head top (rest pose): 311.0 mm; bob throw 33.9 mm; head collar z 227.0
gimbal / head interference check over bob {0, max} x nod {-30,0,+30} x tilt {-25,0,+25}:
  worst overlap mm3: 0.0
