danpillay87/puppet-base-cad/build_shells.py

r"""
Character shells and clip-on accessories for the universal puppet base (CadQuery).

Run:  .venv\Scripts\python.exe build_shells.py              # build everything, write STLs + out/shells_report.csv + preview
      .venv\Scripts\python.exe build_shells.py pear frog     # only some parts (names: pear frog heart jolly claude beret glasses sunglasses)
      add --no-preview to skip the picture.

This file only IMPORTS the geometry helpers and the head dimensions from build_puppet_base.py (it changes nothing there).
Head frame: origin = centre of the magnet collar plane, +Z up, +Y = front. The head sphere centre is HEAD_CUT_DZ (about 24 mm) above it.
All units are millimetres. Numbers marked (CHECK) are best guesses to confirm on the first print.
"""
import math
import os
import sys

import cadquery as cq

import build_puppet_base as B

# =====================================================================================
# PARAMETERS (shells and clip-ons)
# =====================================================================================
SHELL_WALL = B.SHELL_WALL                     # 1.5 mm hollow wall for every character shell
CLIP_WALL = 1.2                               # beret wall
CLIP_FIT = 0.15                               # beret cap radial clearance on the head sphere (friction fit)
MASS_LIMIT_G = 200.0                          # each shell must stay under this (printed, thin wall = near solid)
PLA_G_PER_CM3 = 1.24

# shared geometry (head frame)
ZC = B.HEAD_CUT_DZ                            # head sphere centre height above the collar plane
R0 = B.SHELL_CAV_R + SHELL_WALL               # first blob: swallows the head (cavity 61.8 + wall 1.5)
ZF = B.SHELL_FLOOR_Z                          # underside of the mating ring (-3.2)

# shell split lugs (same on all shells): two M3 across the split at the front and the back
LUG_Y0 = 59.0                                 # lug blocks start outside the head's bulge at their height
LUG_HOLE_Y = 62.0
LUG_HOLE_Z = 4.0
LUG_Z_TOP = 8.0

# Jolly (hooded head + shoulders)
JOLLY_HEM_Z = -26.0                           # open lower edge (head frame), raised from -40 (and earlier -58) so the shell clears the column at the full nod 30 + tilt 25 corner at rest. The fixed neck flange tops out at about -64.
SLEEVE_D = B.SLEEVE_D                         # 35 mm plush sleeve
ARM_CLEAR = 3.0                               # sleeve slot clearance
ARM_SLOT_ANGLES = range(50, 85, 5)            # arm directions (deg above horizontal) that sweep through the shoulder flank
ARM_SLOT_LEN = 122.0                          # stop at the sleeve length, so the head side is never slotted
HOOD_RING_R = 42.0                            # radius of the hood's face opening (viewed from the front)
HOOD_TUBE_R = 3.0                             # thickness of the hood edge ridge

# round glasses (worn by Pear) / sunglasses (worn by Heart). They clip onto the SHELL, not the bare head, so each one is built
# from its wearer's blobs: every piece is a thin skin lying CLIP_GAP off the shell surface, and the front outline is pushed
# straight back along -Y onto that skin. Seen from the front the rims are true circles (the stage look); the frame follows the face.
CLIP_GAP = 0.3                                # clearance between the clip and the shell surface
CLIP_T = 2.0                                  # thickness of the frame skin
TEMPLE_H = 5.0                                # temple band height
TEMPLE_END = 115.0                            # degrees round from the front: past the widest point = the hook behind
GLASSES_ZC = ZC + 39.0                        # Pear's eye height: 60% of the way up the shell, where it is 72% of its widest (stage cut-out: 60%, 72%)
ROUND_R_OUT, ROUND_R_IN, ROUND_X = 13.0, 10.8, 17.3     # round rims 26 mm across, centres 34.6 apart (stage: 18% and 25% of Pear's width)
SUN_ZC = ZC + 32.0                            # Heart: 56% of the way up, across the middle of the heart (stage cut-out: 56%)
SUN_W, SUN_H, SUN_R, SUN_X = 31.6, 21.0, 7.0, 19.0      # lens plates 24% x 16% of Heart's width, centres 28% apart (stage)

# beret (friction-fit cap + flat saucer)
BERET_RIM_DZ = 22.0                           # cap rim height above the head centre (rim polar angle about 70 degrees)
BERET_RXY, BERET_RZ = 54.0, 14.0              # saucer radius / half thickness
BERET_CZ = 54.0                               # saucer centre height above the head centre
BERET_DX = 7.0                                # sideways offset (a beret sits off-centre)

# Claude = "Clawd", the Claude Code mascot made plush: a chunky rounded-cube body, two short stub arms sticking out sideways at
# mid height, and four stubby legs underneath. The body and the arms are the printed shell. The four legs are NOT printed: they are
# soft stuffed fleece tubes sewn to the skin (see CLAWD_LEG_* and clawd_soft_legs, which is only drawn in the preview pictures),
# because printed legs hang straight down into the neck gimbal and the column when the head nods and tilts (check_shell_clearance.py).
CLAWD_WALL = 1.0                              # thinner than the 1.5 mm of the round shells, on purpose: a cube round the 120 mm head sphere has far
                                              # more skin than a sphere. Measured shell pair (near-solid): 1.5 mm = 154.9 g (head 277 g, over the
                                              # 250 g budget), 1.2 mm = 127.5 g (head 250 g, no margin), 1.0 mm = 109 g (head 231 g)
CLAWD_W = 126.0                               # body width (x). The head cavity (R 61.8) plus this wall needs at least 125.6
CLAWD_D = 130.0                               # body depth (y). Same minimum, plus room for the M3 lugs at the front and back seam
CLAWD_H = 110.0                               # body height, from the underside of the mating plate (ZF) up
CLAWD_R_VERT = 18.0                           # rounded vertical edges
CLAWD_R_TOP = 16.0                            # rounded top edges (a little under the vertical radius so the corners blend)
CLAWD_R_BOT = 8.0                             # bottom edges: small, the six magnet pockets (radius 54 mm) need a flat floor out to 56
CLAWD_ARM_LEN = 35.0                          # how far each stub arm sticks out of the flat side face
CLAWD_ARM_D = 40.0                            # arm thickness front to back (y)
CLAWD_ARM_H = 37.0                            # arm height: about a third of the body
CLAWD_ARM_R = 12.0                            # rounded arm edges and end
CLAWD_ARM_ROOT = 25.0                         # the arm block starts this far inside the side face (buried in the body)
CLAWD_PLATE_R = 58.0                          # the solid 3.2 mm mating plate is only a ring out to this radius; outside it the floor is a plain wall
CLAWD_LUG_YB = 64.8                           # lug blocks stop just inside the front/back wall (outer face at 65.0), so nothing pokes out
CLAWD_LEG_N, CLAWD_LEG_W, CLAWD_LEG_D = 4, 22.0, 30.0   # soft legs (preview only): count, width (x), depth (y)
CLAWD_LEG_LEN = 28.0                          # how far they hang below the underside of the plate
CLAWD_LEG_EDGE = 58.0                         # outer edge of the outer legs, inside the 63 mm half width of the body
CLAWD_LEG_R = 9.0

# =====================================================================================
# shell builder
# =====================================================================================


def shell_full(blobs, zmin=ZF, wall=SHELL_WALL, extra_cuts=(), extra_add=()):
    """Hollow shell = union of spheroids minus the same spheroids shrunk by `wall`, minus the head cavity,
    cut off at height zmin, with the solid 3.2 mm mating plate (Ø96 hole + six magnet pockets opening downward)
    and a screw lug at the front and back seam. blobs = [(cx, cy, cz, r_xy, r_z)] in the head frame.
    extra_add = solid trim (e.g. the hood ridge) fused on after hollowing."""
    outer = B.union_all([B.spheroid(*b) for b in blobs])
    cav = B.union_all([B.spheroid(b[0], b[1], b[2], b[3] - wall, b[4] - wall) for b in blobs]
                      + [cq.Workplane("XY").sphere(B.SHELL_CAV_R).translate((0, 0, ZC))])
    body = outer.cut(cav).intersect(B.box(-300, 300, -300, 300, zmin, 400))
    plate = outer.intersect(B.box(-300, 300, -300, 300, ZF, 0.0)).cut(B.cylz(0, 0, ZF - 1, 1, B.COLLAR_ID / 2))
    shell = body.union(plate)
    for e in extra_add:
        shell = shell.union(e)
    yo = plate.val().BoundingBox().ymax
    yb = max(yo + 6.0, 66.0)
    for sy in (-1, 1):
        ya, yz = sorted((sy * (yo - 3.0), sy * yb))
        shell = shell.union(B.box(-8.0, 8.0, ya, yz, ZF, 0.0))                       # lower lug block on the plate
        ya, yz = sorted((sy * LUG_Y0, sy * yb))
        shell = shell.union(B.box(-8.0, 8.0, ya, yz, -0.01, LUG_Z_TOP))              # upper lug block on the wall
    tools = list(B.magnet_pockets(ZF, B.MAG_POCKET_DEPTH, -1)) + list(extra_cuts)
    return B.cut_all(shell, tools)


def shell_halves(blobs, **kw):
    """Left half = x <= 0; right half = its mirror image (a straight x >= 0 cut of a union of spheres upsets the kernel,
    the mirror is exact). Lug holes are cut last: 3.4 mm clearance on the left, 2.7 mm pilot on the right."""
    full = shell_full(blobs, **kw)
    left0 = B.half(full, -1)
    right0 = left0.mirror("YZ")
    left = B.cut_all(left0, [B.cylx(-9.0, 0.5, sy * LUG_HOLE_Y, LUG_HOLE_Z, 1.7) for sy in (-1, 1)])
    right = B.cut_all(right0, [B.cylx(-0.5, 9.0, sy * LUG_HOLE_Y, LUG_HOLE_Z, 1.35) for sy in (-1, 1)])
    return left, right


def shell_full_solid(outer, cav, zmin=ZF, extra_cuts=(), extra_add=(), plate_r=None, lug_yb=None):
    """Variant of shell_full for shapes that are not a plain union of spheroids (shell_full itself is untouched).
    outer = the finished outer solid, cav = the finished cavity solid (the outer shape shrunk by the wall; the Ø123.6 head
    cavity is added here). Everything after that is the same recipe as shell_full: cut off at zmin, solid 3.2 mm mating
    plate taken from the outer shape (Ø96 hole, six magnet pockets opening downward) and an M3 lug block at the front and
    back seam.
    plate_r (default none) limits the thick plate to a ring out to that radius; the floor outside it is then just the shell
    wall (a wide flat-bottomed shape would otherwise carry a 3.2 mm slab across its whole footprint).
    lug_yb (default max(plate edge + 6, 66)) is the y where the two lug blocks stop: the outer face of a flat front/back wall.
    When lug_yb is given the blocks are also trimmed to the outer shape, so they cannot poke out through a rounded bottom edge."""
    cav = cav.union(cq.Workplane("XY").sphere(B.SHELL_CAV_R).translate((0, 0, ZC)))
    body = outer.cut(cav).intersect(B.box(-300, 300, -300, 300, zmin, 400))
    plate = outer.intersect(B.box(-300, 300, -300, 300, ZF, 0.0)).cut(B.cylz(0, 0, ZF - 1, 1, B.COLLAR_ID / 2))
    if plate_r is not None:
        plate = plate.intersect(B.cylz(0, 0, ZF - 1, 1, plate_r))
    shell = body.union(plate)
    for e in extra_add:
        shell = shell.union(e)
    yo = plate.val().BoundingBox().ymax
    yb = lug_yb if lug_yb is not None else max(yo + 6.0, 66.0)
    for sy in (-1, 1):
        ya, yz = sorted((sy * (yo - 3.0), sy * yb))
        low = B.box(-8.0, 8.0, ya, yz, ZF, 0.0)
        ya, yz = sorted((sy * LUG_Y0, sy * yb))
        up = B.box(-8.0, 8.0, ya, yz, -0.01, LUG_Z_TOP)
        if lug_yb is not None:
            low, up = low.intersect(outer), up.intersect(outer)
        shell = shell.union(low).union(up)
    tools = list(B.magnet_pockets(ZF, B.MAG_POCKET_DEPTH, -1)) + list(extra_cuts)
    return B.cut_all(shell, tools)


def shell_halves_solid(outer, cav, **kw):
    """Left/right halves of shell_full_solid, split exactly like shell_halves (right = mirror of left, lug holes cut last)."""
    full = shell_full_solid(outer, cav, **kw)
    left0 = B.half(full, -1)
    right0 = left0.mirror("YZ")
    left = B.cut_all(left0, [B.cylx(-9.0, 0.5, sy * LUG_HOLE_Y, LUG_HOLE_Z, 1.7) for sy in (-1, 1)])
    right = B.cut_all(right0, [B.cylx(-0.5, 9.0, sy * LUG_HOLE_Y, LUG_HOLE_Z, 1.35) for sy in (-1, 1)])
    return left, right


def rounded_box(x0, x1, y0, y1, z0, z1, r_vert, r_top, r_bot):
    """Box with its four vertical edges, its top edges and its bottom edges rounded (radii r_vert, r_top, r_bot; 0 = sharp)."""
    b = B.box(x0, x1, y0, y1, z0, z1)
    if r_vert > 0:
        b = b.edges("|Z").fillet(r_vert)
    if r_top > 0:
        b = b.faces(">Z").edges().fillet(r_top)
    if r_bot > 0:
        b = b.faces("<Z").edges().fillet(r_bot)
    return b


def clawd_zmid():
    """Height of the middle of the body (head frame): where the two stub arms are centred."""
    return ZF + CLAWD_H / 2.0


def clawd_arm(sign, inset=0.0):
    """One stub arm: a rounded block sticking straight out sideways (sign = +1 right, -1 left) from the middle height of the body.
    It starts CLAWD_ARM_ROOT inside the side face so it fuses with the body. inset > 0 shrinks it by the wall (used for the cavity)."""
    x_in = CLAWD_W / 2 - CLAWD_ARM_ROOT
    x_out = CLAWD_W / 2 + CLAWD_ARM_LEN - inset
    zm, hd, hh = clawd_zmid(), CLAWD_ARM_D / 2 - inset, CLAWD_ARM_H / 2 - inset
    blk = B.box(x_in, x_out, -hd, hd, zm - hh, zm + hh).edges().fillet(CLAWD_ARM_R - inset)
    return blk if sign > 0 else blk.mirror("YZ")


def clawd_solids(wall=CLAWD_WALL):
    """(outer, cavity) of Clawd: the rounded-cube body plus the two stub arms; the cavity is the same shapes shrunk by the wall
    (so the arms are hollow and open into the body). The head sphere cavity is added in shell_full_solid."""
    hw, hd = CLAWD_W / 2, CLAWD_D / 2
    z0, z1 = ZF, ZF + CLAWD_H
    body = rounded_box(-hw, hw, -hd, hd, z0, z1, CLAWD_R_VERT, CLAWD_R_TOP, CLAWD_R_BOT)
    body_c = rounded_box(-hw + wall, hw - wall, -hd + wall, hd - wall, z0 + wall, z1 - wall,
                         CLAWD_R_VERT - wall, CLAWD_R_TOP - wall, CLAWD_R_BOT - wall)
    outer = B.union_all([body] + [clawd_arm(s) for s in (-1, 1)])
    cav = B.union_all([body_c] + [clawd_arm(s, inset=wall) for s in (-1, 1)])
    return outer, cav


def clawd_soft_legs():
    """The four soft stuffed fleece legs, drawn for the preview pictures only (NOT printed, not part of any STL in out/ except
    the coarse preview copy): CLAWD_LEG_N rounded blocks in a row across the middle of the depth, evenly spaced, the outer edges of
    the outer pair at +/-CLAWD_LEG_EDGE, hanging CLAWD_LEG_LEN below the underside of the mating plate. Head frame."""
    n, w = CLAWD_LEG_N, CLAWD_LEG_W
    c_out = CLAWD_LEG_EDGE - w / 2
    xs = [-c_out + i * (2 * c_out) / (n - 1) for i in range(n)]
    legs = [B.box(x - w / 2, x + w / 2, -CLAWD_LEG_D / 2, CLAWD_LEG_D / 2, ZF - CLAWD_LEG_LEN, ZF + 6.0)
            .faces("<Z").edges().fillet(CLAWD_LEG_R) for x in xs]
    return B.union_all(legs)


def pear_blobs():
    return [
        (0, 0, ZC, R0, R0),                    # swallows the head
        (0, 0, ZC - 8.0, 70.0, 54.0),          # broad belly (Ø140), cut flat by the mating plane
        (0, 0, ZC + 40.0, 40.0, 44.0),         # narrower shoulder dome
        (2.0, 0, ZC + 90.0, 5.5, 10.0),        # stalk
    ]


def frog_blobs():
    return [
        (0, 0, ZC, R0, R0),
        (-45.0, 6.0, ZC - 6.0, 26.0, 20.0),    # left cheek
        (45.0, 6.0, ZC - 6.0, 26.0, 20.0),     # right cheek
        (-30.0, 10.0, ZC + 52.0, 21.0, 21.0),  # left eye dome
        (30.0, 10.0, ZC + 52.0, 21.0, 21.0),   # right eye dome
    ]


def heart_blobs():
    return [
        (0, 0, ZC, R0, R0),
        (-29.0, 0, ZC + 42.0, 38.0, 38.0),     # left lobe
        (29.0, 0, ZC + 42.0, 38.0, 38.0),      # right lobe
    ]


def jolly_blobs():
    return [
        (0, 0, ZC, R0, R0),
        (0, -6.0, ZC + 52.0, 27.0, 24.0),      # hood peak
        (0, 0, -30.0, 72.0, 56.0),             # shoulders (Ø144), open at the hem
    ]


def arm_slots():
    """Clearance slots on the shoulder flanks so the Ø35 sleeves can swing up to 80 degrees: the sleeve is swept about each
    shoulder socket (x = +/-67.1, 119 mm below the collar plane at rest) and cut out of the shell."""
    px, pz = B.SK_SHAFT_X, B.SK_ZC - B.HEAD_Z0_ABS
    yc = B.SK_HORN_Y0 + B.HORN_BOSS_T / 2
    r = SLEEVE_D / 2 + ARM_CLEAR
    cyls = [B.cylx(0.0, ARM_SLOT_LEN, yc, 0.0, r).rotate((0, 0, 0), (0, 1, 0), -a).translate((px, 0, pz))
            for a in ARM_SLOT_ANGLES]
    right = B.union_all(cyls)
    return [right, right.mirror("YZ")]


def build_pear():
    return shell_halves(pear_blobs())


def build_frog():
    return shell_halves(frog_blobs())


def build_heart():
    return shell_halves(heart_blobs())


def hood_ridge():
    """The edge of the hood: a thin arch round the face opening (a torus tube of radius 3 whose centre-line sits on a sphere
    1.2 mm outside the shell, so half of it is proud of the surface). Only the part above z = 14 is kept; the head cavity is
    cut out of it so nothing can touch the head."""
    ring_r, tube_r = HOOD_RING_R, HOOD_TUBE_R
    y0 = math.sqrt((R0 + 1.2) ** 2 - ring_r ** 2)
    tor = (cq.Workplane("XY").center(ring_r, 0).circle(tube_r).revolve(360, (-ring_r, 0, 0), (-ring_r, 1, 0))
           .translate((0, y0, ZC)))
    tor = tor.intersect(B.box(-300, 300, 0, 300, ZC - 10.0, 400))
    return tor.cut(cq.Workplane("XY").sphere(B.SHELL_CAV_R).translate((0, 0, ZC)))


def build_jolly():
    return shell_halves(jolly_blobs(), zmin=JOLLY_HEM_Z, extra_cuts=arm_slots(), extra_add=[hood_ridge()])


def build_claude():
    outer, cav = clawd_solids()
    return shell_halves_solid(outer, cav, plate_r=CLAWD_PLATE_R, lug_yb=CLAWD_LUG_YB)


# =====================================================================================
# clip-ons
# =====================================================================================
def wedge(phi0, phi1, z0, z1):
    """Pie slice about the Z axis between two azimuths (degrees, measured from +Y (front) toward +X), from z0 to z1."""
    p0, p1 = math.radians(phi0), math.radians(phi1)
    pts = [(0, 0), (300 * math.sin(p0), 300 * math.cos(p0)), (300 * math.sin(p1), 300 * math.cos(p1))]
    return cq.Workplane("XY").workplane(offset=z0).polyline(pts).close().extrude(z1 - z0)


def rrect_y(y0, y1, cx, cz, w, h, r):
    """Rounded rectangle plate in the XZ plane, thickness along Y from y0 to y1."""
    return (cq.Workplane("XZ").workplane(offset=-y1).center(cx, cz).rect(w, h).extrude(y1 - y0)
            .edges("|Y").fillet(r))


def clip_skin(blobs):
    """A CLIP_T thick layer lying CLIP_GAP off the outside of a blob shell: every spheroid grown by the gap, minus the same
    spheroids grown by the gap plus the thickness. A clip-on is the part of this skin under its outline, so it is flush."""
    def grown(d):
        return B.union_all([B.spheroid(b[0], b[1], b[2], b[3] + d, b[4] + d) for b in blobs])
    return grown(CLIP_GAP + CLIP_T).cut(grown(CLIP_GAP))


def temple_band(skin, x_start, zc):
    """Right temple: the TEMPLE_H tall strip of the skin centred at height zc, from x_start (inside the outer edge of the right
    lens) round the side of the shell to TEMPLE_END degrees, behind the widest point (the hook that keeps the clip on)."""
    z0, z1 = zc - TEMPLE_H / 2, zc + TEMPLE_H / 2
    return skin.intersect(wedge(0.0, TEMPLE_END, z0, z1)).intersect(B.box(x_start, 300, -300, 300, z0, z1))


def build_glasses_round():
    """Round glasses for Pear: two rims and a bridge on the front of the Pear shell at its eye height, temples round the sides."""
    skin, zc = clip_skin(pear_blobs()), GLASSES_ZC
    rims = [B.cyly(0, 200, sx * ROUND_X, zc, ROUND_R_OUT).cut(B.cyly(-1, 201, sx * ROUND_X, zc, ROUND_R_IN)) for sx in (-1, 1)]
    bridge = B.box(-ROUND_X + ROUND_R_IN + 0.3, ROUND_X - ROUND_R_IN - 0.3, 0, 200, zc - 1.2, zc + 1.2)
    front = skin.intersect(B.union_all(rims + [bridge]))   # one cut of the skin (a bridge fused on afterwards gives a bad solid)
    temple = temple_band(skin, ROUND_X + ROUND_R_IN + 0.6, zc)
    return front.union(temple).union(temple.mirror("YZ"))


def build_glasses_sun():
    """Sunglasses for Heart: two lens plates joined at the top across the middle of the Heart shell, temples round the sides."""
    skin, zc = clip_skin(heart_blobs()), SUN_ZC
    lenses = [rrect_y(0, 200, sx * SUN_X, zc, SUN_W, SUN_H, SUN_R) for sx in (-1, 1)]
    bridge = B.box(-8.0, 8.0, 0, 200, zc + SUN_H / 2 - 5.5, zc + SUN_H / 2 - 1.5)
    front = skin.intersect(B.union_all(lenses + [bridge]))
    temple = temple_band(skin, SUN_X + SUN_W / 2 - 2.0, zc + 2.0)
    return front.union(temple).union(temple.mirror("YZ"))


def build_beret():
    zr = ZC + BERET_RIM_DZ
    r_in = B.HEAD_R + CLIP_FIT
    cap = cq.Workplane("XY").sphere(r_in + CLIP_WALL).translate((0, 0, ZC)).intersect(B.box(-300, 300, -300, 300, zr, 400))
    saucer = B.spheroid(BERET_DX, 0, ZC + BERET_CZ, BERET_RXY, BERET_RZ)
    stalk = B.cylz(BERET_DX, 0, ZC + BERET_CZ + BERET_RZ - 3.0, ZC + BERET_CZ + BERET_RZ + 5.0, 3.5)
    outer = cap.union(saucer)
    cav = cq.Workplane("XY").sphere(r_in).translate((0, 0, ZC)).union(
        B.spheroid(BERET_DX, 0, ZC + BERET_CZ, BERET_RXY - CLIP_WALL, BERET_RZ - CLIP_WALL))
    hat = outer.cut(cav).intersect(B.box(-300, 300, -300, 300, zr, 400))
    return hat.union(stalk)


# =====================================================================================
# parts list + export
# =====================================================================================
AX, AY, AZ = B.AX, B.AY, B.AZ

# (name, builder, kind, rotations key, supports note)
JOBS = {
    "pear": (build_pear, "halves"),
    "frog": (build_frog, "halves"),
    "heart": (build_heart, "halves"),
    "jolly": (build_jolly, "halves"),
    "claude": (build_claude, "halves"),
    "beret": (build_beret, "single"),
    "glasses": (build_glasses_round, "single"),
    "sunglasses": (build_glasses_sun, "single"),
}

SUPPORT_NOTES = {
    "pear": "YES: crown of the dome and the stalk; tree supports (lies on its split face)",
    "frog": "YES: eye domes and cheeks; tree supports (lies on its split face)",
    "heart": "YES: both lobes; tree supports (lies on its split face)",
    "jolly": "YES: hood peak, shoulder flank slots and the rim of the open hem; tree supports (lies on its split face)",
    "claude": "YES: the flat roof of the body (the inside of the outer side wall) and the flat end of each stub arm, plus the rounded top and bottom edges; tree supports (lies on its split face). 1.0 mm wall",
    "beret": "YES: underside of the saucer (print crown-down on the stalk with tree supports, or rim-down with supports under the saucer)",
    "glasses": "YES: light tree supports under the lower rims and the temple bands (print it the way Pear wears it; the curved frame leans back about 38 degrees, inside the 45 degree rule)",
    "sunglasses": "YES: light tree supports under the lens plates and the temple bands (print it the way Heart wears it; the curved frame leans back about 30 degrees, inside the 45 degree rule)",
}

SINGLE_ROT = {
    "beret": [(AX, 180)],                      # crown down
    "glasses": [],                             # as worn: the curved frame cannot lie flat
    "sunglasses": [],
}
HALF_ROT = {"left": [(AY, 90)], "right": [(AY, -90)]}    # split face down, like the head halves

STL_NAMES = {
    "pear": ("shell_pear_left", "shell_pear_right"),
    "frog": ("shell_frog_left", "shell_frog_right"),
    "heart": ("shell_heart_left", "shell_heart_right"),
    "jolly": ("shell_jolly_left", "shell_jolly_right"),
    "claude": ("shell_claude_left", "shell_claude_right"),
    "beret": ("clip_beret",),
    "glasses": ("clip_glasses_round",),
    "sunglasses": ("clip_sunglasses",),
}


def pose_head_frame(wp, bob=0.0, nod=0.0, tilt=0.0):
    """Move a head-frame part (collar plane z = 0) to where the head sits for a given bob (mm), nod and tilt (degrees).
    This is exactly the transform B.assemble() applies to head_L / head_R (translate up to the collar plane, tilt about Y,
    then nod about X), so a shell posed with it moves with the head. Used by check_shell_clearance.py and render_preview.py."""
    wp = wp.translate((0, 0, B.HEAD_Z0_ABS + bob))
    wp = wp.rotate((0, 0, B.TILT_AXIS_Z + bob), (0, 1, B.TILT_AXIS_Z + bob), tilt)
    return wp.rotate((0, 0, B.NOD_AXIS_Z + bob), (1, 0, B.NOD_AXIS_Z + bob), nod)


def describe(name, wp):
    v = wp.val()
    return v.isValid(), len(wp.solids().vals()), v.Volume() / 1000.0


def main(selected=None, preview=True, build=True):
    out = B.OUT_DIR
    os.makedirs(out, exist_ok=True)
    asm = os.path.join(out, "_assembly", "_shells")
    os.makedirs(asm, exist_ok=True)
    names = (selected or list(JOBS.keys())) if build else []
    head_L, head_R = B.build_head_halves()
    head_full = head_L.union(head_R)
    rows, posed = [], {}
    for key in names:
        fn, kind = JOBS[key]
        parts = fn()
        parts = list(parts) if kind == "halves" else [parts]
        fnames = STL_NAMES[key]
        total_cm3 = 0.0
        for i, (fname, wp) in enumerate(zip(fnames, parts)):
            ok, nsol, vol = describe(fname, wp)
            rots = HALF_ROT["left" if i == 0 else "right"] if kind == "halves" else SINGLE_ROT[key]
            pw = B.settle(wp, rots)
            path = os.path.join(out, fname + ".stl")
            B.export_stl(pw, path)
            bb = pw.val().BoundingBox()
            g_solid = vol * PLA_G_PER_CM3
            total_cm3 += vol
            rows.append((fname, 1, vol, bb.xlen, bb.ylen, bb.zlen, vol * PLA_G_PER_CM3 * 0.25, g_solid, SUPPORT_NOTES[key],
                         ok, nsol, os.path.getsize(path)))
            print(f"{fname:22s} {bb.xlen:6.1f} x {bb.ylen:6.1f} x {bb.zlen:6.1f} mm  {vol:6.1f} cm3  {g_solid:6.1f} g (near-solid)"
                  f"  valid={ok} solids={nsol}  {os.path.getsize(path) / 1e6:5.2f} MB", flush=True)
        # whole-part checks: mass, and does it hit the head?
        whole = parts[0].union(parts[1]) if kind == "halves" else parts[0]
        hit = B.overlap_mm3(whole, head_full)
        g_total = total_cm3 * PLA_G_PER_CM3
        flag = "OK" if g_total < MASS_LIMIT_G else "OVER LIMIT"
        bb = whole.val().BoundingBox()
        print(f"  -> {key}: total {g_total:.0f} g solid-equivalent ({flag} vs {MASS_LIMIT_G:.0f} g), overall "
              f"{bb.xlen:.0f} wide x {bb.ylen:.0f} deep x {bb.zlen:.0f} tall (z {bb.zmin:.0f}..{bb.zmax:.0f}), "
              f"overlap with head {hit:.1f} mm3", flush=True)
        posed[key] = whole
    # append to a separate report (the base part report is left alone)
    rep = os.path.join(out, "shells_report.csv")
    old = {}
    if os.path.exists(rep):
        with open(rep, encoding="utf-8") as f:
            for line in f.read().splitlines()[1:]:
                if line.strip():
                    old[line.split(",")[0]] = line
    for r in rows:
        old[r[0]] = ",".join([r[0], str(r[1]), f"{r[2]:.1f}", f"{r[3]:.1f}", f"{r[4]:.1f}", f"{r[5]:.1f}", f"{r[6]:.1f}",
                              f"{r[7]:.1f}", '"' + r[8] + '"', str(r[9]), str(r[10]), str(r[11])])
    with open(rep, "w", encoding="utf-8") as f:
        f.write("file,copies,volume_cm3,x_mm,y_mm,z_mm,grams_25pct_rule,grams_near_solid,supports,valid,solids,stl_bytes\n")
        for k in sorted(old):
            f.write(old[k] + "\n")
    # coarse head-frame STLs for the preview
    for key, wp in posed.items():
        B.export_stl(wp, os.path.join(asm, key + ".stl"), tol=0.12, ang=0.35)
    if "claude" in posed:                                   # preview only: Clawd's soft legs are not printed
        B.export_stl(clawd_soft_legs(), os.path.join(asm, "claude_legs.stl"), tol=0.12, ang=0.35)
    if preview:
        render_preview(head_full)


# =====================================================================================
# preview picture (VTK off-screen; falls back to nothing if VTK is missing)
# =====================================================================================
PREVIEW_COLORS = {
    "cloud": (0.80, 0.90, 1.00), "pear": (0.62, 0.80, 0.35), "frog": (0.35, 0.72, 0.40), "heart": (0.95, 0.45, 0.55),
    "jolly": (0.90, 0.92, 0.96), "claude": (0.85, 0.47, 0.34), "beret": (0.75, 0.25, 0.30), "glasses": (0.15, 0.15, 0.18), "sunglasses": (0.10, 0.10, 0.12),
    "head": (0.96, 0.90, 0.78), "softlegs": (0.85, 0.47, 0.34),
}
PREVIEW_OPACITY = {"softlegs": 0.45}                        # Clawd's four legs are sewn fleece, not printed: drawn see-through


def render_preview(head_full):
    try:
        import vtk
    except Exception as e:  # pragma: no cover
        print("preview skipped (VTK not importable):", repr(e)[:120])
        return
    out = B.OUT_DIR
    pdir = os.path.join(out, "_assembly", "_shells", "_pose")
    os.makedirs(pdir, exist_ok=True)
    cloud_L, cloud_R = B.build_cloud_former_halves()
    items = []                                              # (label, workplane, colour key, dx, dz)
    row1 = [("cloud", cloud_L.union(cloud_R)), ("pear", None), ("frog", None), ("heart", None), ("jolly", None),
            ("claude", None)]
    asm = os.path.join(out, "_assembly", "_shells")
    step = 205.0                                            # six shells; Clawd with its stub arms is 196 mm wide, so the step is a little wider than it
    x = 2.5 * step                                          # seen from the front +X is on the left of the picture
    for key, wp in row1:
        items.append((key, wp, key, x, 0.0, os.path.join(asm, key + ".stl")))
        if key == "claude":                                 # the four soft (sewn, not printed) legs, drawn see-through under the body
            items.append(("claude_legs", None, "softlegs", x, 0.0, os.path.join(asm, "claude_legs.stl")))
        x -= step
    row2 = [("beret", "beret", None), ("glasses", "glasses", "pear"), ("sunglasses", "sunglasses", "heart")]
    x = 175.0
    for key, ck, wearer in row2:                            # the beret on the bare head; the glasses on the shell they are built for
        if wearer is None:
            items.append(("head_" + key, head_full, "head", x, -200.0, None))
        else:
            items.append(("wearer_" + key, None, wearer, x, -200.0, os.path.join(asm, wearer + ".stl")))
        items.append((key, None, ck, x, -200.0, os.path.join(asm, key + ".stl")))
        x -= 175.0
    ren = vtk.vtkRenderer()
    ren.SetBackground(1, 1, 1)
    ren.SetBackground2(0.88, 0.92, 0.97)
    ren.GradientBackgroundOn()
    for label, wp, ck, dx, dz, path in items:
        if path is None or not os.path.exists(path):
            if wp is None:
                continue
            path = os.path.join(pdir, label + ".stl")
            B.export_stl(wp.translate((dx, 0, dz)), path, tol=0.12, ang=0.35)
        elif label != "cloud":
            # asm STLs are in the head frame: re-export shifted copies
            import trimesh
            m = trimesh.load(path, force="mesh")
            m.apply_translation((dx, 0, dz))
            path = os.path.join(pdir, label + ".stl")
            m.export(path)
        if label == "cloud":
            path = os.path.join(pdir, "cloud.stl")
            B.export_stl(wp.translate((dx, 0, dz)), path, tol=0.12, ang=0.35)
        r = vtk.vtkSTLReader()
        r.SetFileName(path)
        r.Update()
        norm = vtk.vtkPolyDataNormals()
        norm.SetInputConnection(r.GetOutputPort())
        norm.SetFeatureAngle(50)
        norm.Update()
        mp = vtk.vtkPolyDataMapper()
        mp.SetInputConnection(norm.GetOutputPort())
        a = vtk.vtkActor()
        a.SetMapper(mp)
        a.GetProperty().SetColor(*PREVIEW_COLORS[ck])
        a.GetProperty().SetOpacity(PREVIEW_OPACITY.get(ck, 1.0))
        a.GetProperty().SetSpecular(0.25)
        ren.AddActor(a)
    txt = vtk.vtkTextActor()
    txt.SetInput("Top: cloud, pear, frog, heart, hooded Jolly, Clawd (Claude) shells.   Bottom: beret on the bare head, round glasses on Pear, sunglasses on Heart.\n"
                 "Clawd's four legs are soft sewn fleece, not printed, so they are drawn see-through.")
    txt.GetTextProperty().SetFontSize(24)
    txt.GetTextProperty().SetColor(0.1, 0.1, 0.15)
    txt.SetPosition(20, 925)
    ren.AddViewProp(txt)
    win = vtk.vtkRenderWindow()
    win.SetOffScreenRendering(1)
    win.SetSize(2000, 1000)
    win.SetMultiSamples(4)
    win.AddRenderer(ren)
    cam = ren.GetActiveCamera()
    cam.SetViewUp(0, 0, 1)
    cam.SetFocalPoint(0, 0, -50)
    cam.SetPosition(0, 1500, 60)                              # +Y is the front: look at the faces
    cam.Azimuth(-18)
    cam.SetViewAngle(24)
    ren.ResetCamera()
    cam.Zoom(1.42)                                            # six shells across the top row (was 1.55 for five)
    ren.ResetCameraClippingRange()
    win.Render()
    w2i = vtk.vtkWindowToImageFilter()
    w2i.SetInput(win)
    w2i.Update()
    png = os.path.join(out, "preview_shells.png")
    wr = vtk.vtkPNGWriter()
    wr.SetFileName(png)
    wr.SetInputConnection(w2i.GetOutputPort())
    wr.Write()
    print(f"preview: {png} (VTK off-screen)")


if __name__ == "__main__":
    args = [a for a in sys.argv[1:] if not a.startswith("--")]
    bad = [a for a in args if a not in JOBS]
    if bad:
        raise SystemExit(f"unknown part(s) {bad}; choose from {list(JOBS)}")
    main(args or None, preview="--no-preview" not in sys.argv, build="--preview-only" not in sys.argv)
