danpillay87/puppet-base-cad/(commit log)

2026-10-18 Universal puppet base: CadQuery source, 34 STLs, previews and print pack
    [arm_horn.stl, base_L.stl, base_R.stl, base_plate_left.stl, base_plate_right.stl, beret.stl, bob_carriage.stl, carriage.stl]
2026-10-20 Add Claude as a sixth toy: starburst shell CAD, clearance check, six-toy print pack and costed spec (rev 16)
    [base_L.stl, base_R.stl, carriage.stl, claude.stl, claude_L.stl, claude_R.stl, cloud.stl, column_L.stl]
2026-10-20 Redraw Claude toy as Clawd: boxy shell with stub arms, soft fleece legs, 1.0 mm wall; new concept images and previews; fleece in parts list (£342.60)
    [base_L.stl, base_R.stl, carriage.stl, claude.stl, claude_L.stl, claude_R.stl, claude_legs.stl, cloud.stl]
2026-10-23 One shared base for all six toys, set up for Andy's printer
    - One-piece base plate replaces the two halves; the old halves are moved to
    out/superseded/ (kept, not deleted) so they can't be printed by mistake.
    - The turntable hub is now its own small part, so the turntable prints without supports.
    - Neck A reshaped to print without supports; tab screw holes now go right through.
    - Every hidden part now prints without supports; only head halves, shells and clip-ons need them.
    - New dummy core (34 g) so the five skins that are off the base keep their shape on the shelf.
    - Glasses and sunglasses clip-on fix in build_shells.py.
    - Andy's Bambu H2D settings in print_settings.py; print_cost.py giv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
    [base.stl, base_L.stl, base_R.stl, base_plate.stl, base_plate_left.stl, base_plate_right.stl, base_pockets.csv, clip_glasses_round.stl]
2026-10-24 Put the turntable servo shaft on the turning axis; first build drops fabric
    The yaw servo pocket in base_plate was centred on the servo body, leaving its
    shaft about 10 mm off the turntable axis. It now sits on the axis (YAW_CX).
    SPEC rev 20: no fabric in the first build (coloured or painted shells, Frog
    first, fur later for Jolly only), about GBP 135 plus paint. Print notes and
    costs updated (base set 757 g).
    [base.stl, base_plate.stl, base_pockets.csv, parts_report.csv, print-quantities.csv]
